Tarnovean/Analog-Signal-Conditioning-Interface/Docs/SCIA_Proiect.pdf

## Facultatea de Electronică, Telecomunicaţii şi Tehnologia Informaţiei

## PROIECT LA DISCIPLINA SCIA

## SEMESTRUL I

2026

## Student:Tarnovean Andrei Gabriel

## Anul de studiu III EA

2 | P a g e

## Cuprins

1. Tematica proiectului
1.1. AI standard cu 3 AO
1.2. Low pass 3 AO V-V KHN
1.3. RG parallel neinversor
1.4. Redresoare bialternanta
2. Dimensionarea etajelor
2.1. AI standard cu 3 AO
2.2. Low pass 3 AO V-V KHN
2.3. RG parallel neinversor
2.4. Redresoare bialternanta
3. Caracterizarea etajelor
3.1. LTspice

3.1.1 AI standard cu 3 AO

3.1.2 Low pass 3 AO V-V KHN

3.1.3 RG parallel neinversor

3.1.4 Redresoare bialternanta

3.2. Scopy

3.2.1 AI standard cu 3 AO

3.2.2 Low pass 3 AO V-V KHN

3.2.3 RG parallel neinversor

3.2.4 Redresoare bialternanta

4. Verificarea si caracterizarea interfetei analogice
5. Concluzii
5.1. AI standard cu 3 AO
5.2. Low pass 3 AO V-V KHN
5.3. RG parallel neinversor
5.4. Redresoare bialternanta

## 1. Tematica proiectului

Structura proiectului este formata din patru etaje : 1) AI standard cu 3 AO, 2) filtrul Low pass 3 AO V-V KHN , 3) configurația RG parallel , 4) Redresorul bialternanță, urmand sa fie dimensionate , simulate si implementate

### 1.1. AI standard cu 3 AO

Acest circuit este un amplificator de instrumentație de tip Tensiune-Tensiune

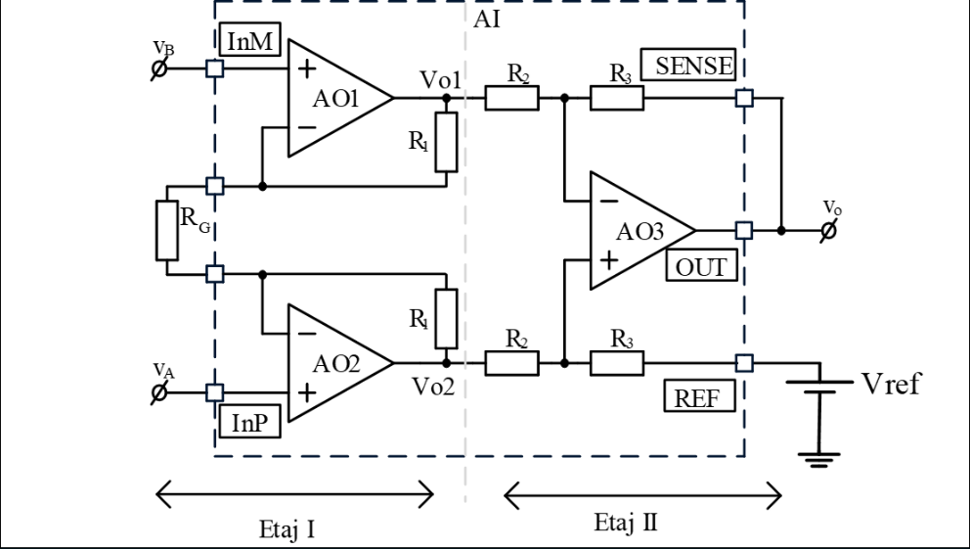
[picture p1: figure]

Acest amplificator de instrumentație cu 3 AO este conceput pentru extragerea precisă a semnalelor mici din medii zgomotoase. Primul etaj captează semnalul fidel, fără a-l influența , iar al doilea elimină interferențele, oferind un semnal de ieșire clar și curat.

### 1.2. Low pass 3 AO V-V KHN

Circuitul reprezintă un filtru biquad universal KHN (Kerwin-Huelsman-Newcomb) în mod tensiune-tensiune cu 3 amplificatoare operaționale, oferind simultan ieșiri low-pass band-pass și high-pass.

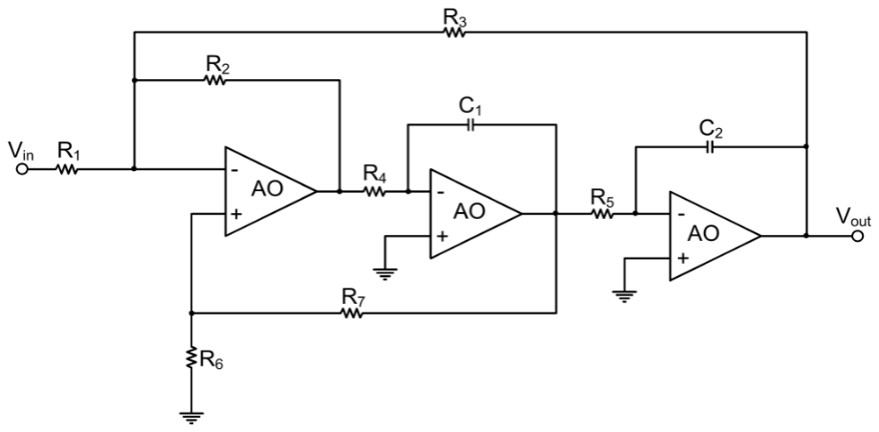
[picture p2: figure]

Funcționează pe bază de două integrate în buclă cu un sumarizator. Ieșirea low-pass are funcția de transfer standard de ordin 2

### 1.3. RG parallel neinversor

Circuitul PGA RG paralel neinversor reprezintă un amplificator operațional (AO) în configurație neinversoare, cu câștig programabil prin comutarea paralelă a rezistențelor la intrarea inversoare (RG echivalent variabil), Rf fixă la ieșire

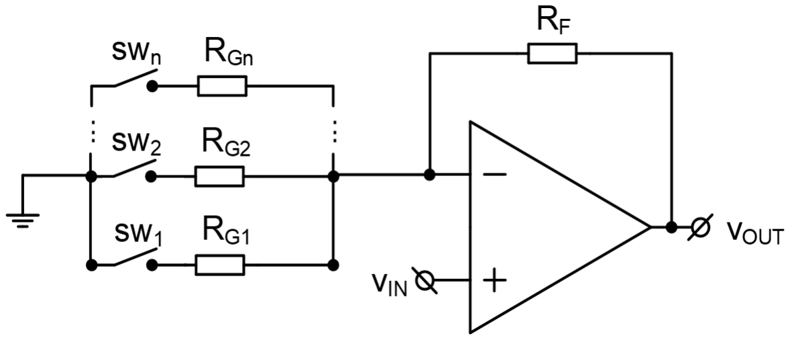
[picture p3: figure]

## 1.4. Redresoare bialternanta

Circuitul reprezintă un redresor de precizie bialternanță realizat cu două amplificatoare operaționale și două diode, unde primul AO funcționează în configurație inversoare pentru redresarea alternanței negative, iar al doilea în configurație neinversoare pentru combinarea semnalelor, rezultând ieșirea ∣ Vout ∣= Av ∣ Vin ∣ pe întreg ciclul

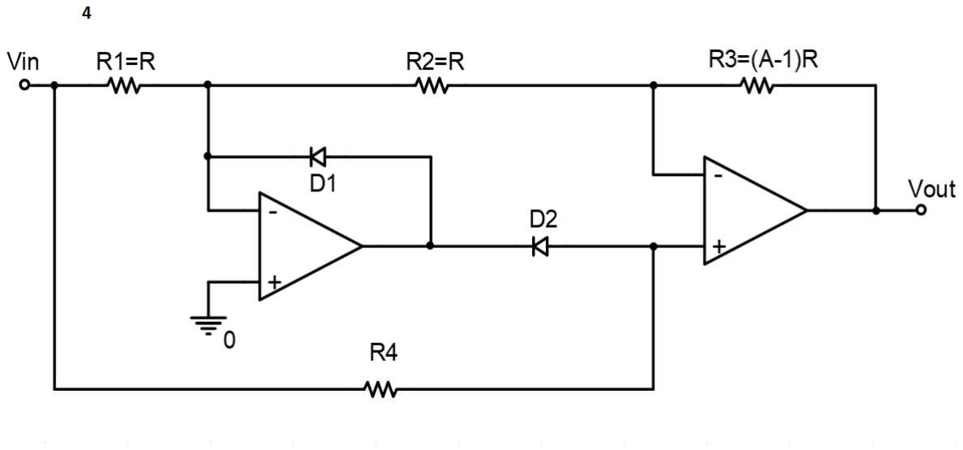
[picture p4: figure]

## 2. Dimensionarea etajelor

### 2.1. AI standard cu 3 AO

Dimensionarea acestui etaj a fost realizată astfel încât să respecte următoarele specificații de proiectare:

1. Amplitudinea minimă la intrare (pentru câștigul maxim PGA): 0.1163 V.
2. Amplitudinea maximă la intrare (pentru câștigul minim PGA): 0.2322 V.
3. Câștigul diferențial Ad = 3.

Considerăm R1 = R2 = R3 = 10k Ω

Ecuatia amplificari diferentiale:

Ad = (1 +

2R1
RG

)

R3
R2

3 = (1 +

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
RG = 10k

### 2.2. Low pass 3 AO V-V KHN

Dimensionarea acestui etaj a fost realizată astfel încât să respecte următoarele specificații de proiectare:

1. |H0| castig liniar in banda de trecere = 1
2. R intrare minim = 750Ω
3. Banda = 7000 Hz
4. Q = 1

Considerăm R1=R2=...=R7=R , rezulta H0 = 1

ω0 = 2π ∗ 7k

Q =

2
3

√
C1
C2

= 1 => C1 =

9
4

C2

Presupunem ca R = 750 Ω , C1 =

3Q
2ω0R

=> C1 = 47nF

Rezultate finale C1 = 10 nF , C2 = 4.7 nF , Q = 0.988 ≅ 1 , R = 4.7k Ω

### 2.3. RG parallel neinversor

Dimensionarea acestui etaj a fost realizată astfel încât să respecte următoarele specificații de proiectare:

1. castig minim [dB] = 8
2. rezolutie (pas minim) [dB] = 2
3. nr pasi = 4
4. castig maxim [dB] = 14

Stabilim RF = 10k

Castigul este : AV = 1 +

RF

RGn + RDSn

Considerând că RDS(on) << RGn , impactul asupra câștigului final fiind sub 0.2%.

RGn =

RF
AV − 1
i. AV,1 = 8 dB => AV,1 = 2.51 V , RG1 =

10k
2.51−1

, RG1 ≈ 6.8 K Ω

ii. AV,2 = 10 dB => AV,2 = 3.16 V , RG2 =

10k
3.16−1

, RG2 ≈ 4.7 K Ω

iii. AV,3 = 12 dB => AV,3 = 3.98 V , RG3 =

10k
3.98−1

, RG3 ≈ 3.3 K Ω

iiii. AV,4 = 14 dB => AV,4 = 5.01 V , RG4 =

10k
5.01−1

, RG4 ≈ 2.2 K Ω

BW =

GBW
AV

=

GBW
1+

RF
RGn

, pentru AD820 GBW = 1.9Mhz

SW4 | SW3 | SW2 | SW1 | RGn | Av | Av [dB] | Eroare [dB] | BW
1 | 0 | 0 | 0 | 2.2 kΩ | 5.55 | 14.9 | +0.9 | 324 k
0 | 1 | 0 | 0 | 3.3 kΩ | 4.03 | 12.1 | +0.1 | 447 k
0 | 0 | 1 | 0 | 4.7 kΩ | 3.13 | 9.9 | -0.1 | 575 k
0 | 0 | 0 | 1 | 6.8 kΩ | 2.47 | 7.9 | -0.1 | 729 k

## 2.4. Redresoare bialternanta

Dimensionarea acestui etaj a fost realizată astfel încât să respecte următoarele specificații de proiectare:

1. |Castig| (linear) = 2

Vout =
{

(1 +

R3
R2

) Vin, Vin < 0

− (

R2 + R3
R1

)Vin, Vin > 0

Conditia de Redresor Bialternanta: (R2+R3)
R1

= 1 +

R3
R2

⇒ R1 = R2

Vout = A ∗ Vin ⇒ A = 1 +

R3
R2

= 2 ⇒

R3
R2

= 1 ⇒ R3 = R2

Stabilim : R1 = R2 = R3 = R4 = 10k

## 3. Caracterizarea etajelor

3.1.LTspice

Implementarea circuitelor în LTspice s-a realizat utilizând modelul amplificatorului operațional AD820, conform cerințelor impuse în specificațiile de proiectare.

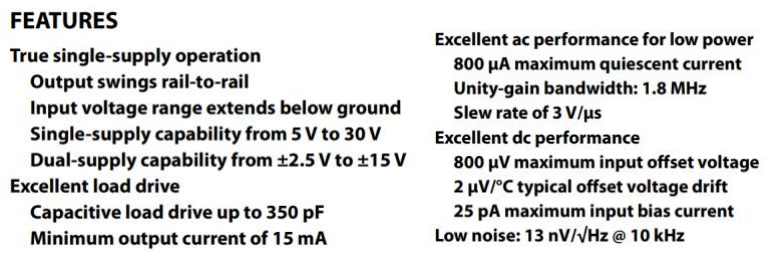
[picture p5: figure]

### 3.1.1. AI standard cu 3 AO

Figura de mai jos ilustrează implementarea completă a circuitului în mediul de simulare LTspice :

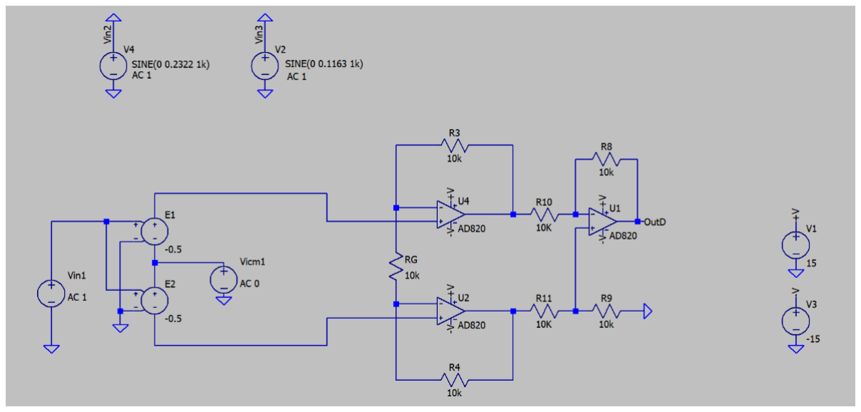
[picture p6: figure]

Pentru generarea semnalului s-a utilizat un model de sursă diferențială echilibrată, configurată pentru a genera cele două niveluri de test necesare analizei PGA: tensiunea minimă de 0.1163 V și tensiunea maximă de 0.2322 V.

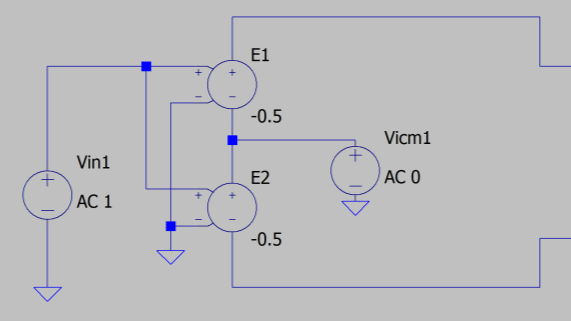
[picture p7: figure]

Pentru validarea funcționalității și caracterizarea performanțelor circuitului proiectat, au fost efectuate următoarele tipuri de analize în mediul de simulare LTspice.

DC op pnt:

Analiza punctului static de funcționare (DC) s-a realizat pentru ambele cazuri, rezultatele simulării fiind prezentate mai jos:

- punct static de functionare correct
Vid = 0.1163 V | Vid = 0.2322V

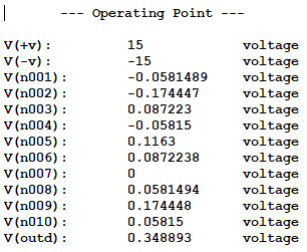
[picture p8: figure]
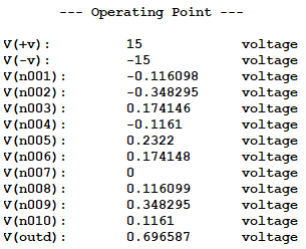
[picture p9: figure]

Valorile simulate (0.34889 V / 0.69658 V) coincid cu cele teoretice, demonstrând un câștig exact de 3 și o polarizare corectă a amplificatoarelor AD820, departe de limitele de saturație

-compensare/ajustare nivel DC la iesire

Pentru a demonstra ajustare a nivelului DC am introdus o tensiune de referință Vref= 1V

Vid = 0.1163 V

Vid = 0.2322 V

AC :

Analiza răspunsului în frecvență a circuitului s-a efectuat utilizând directiva de simulare .ac dec 100 .01 10Meg

- castig la joasa frecventa

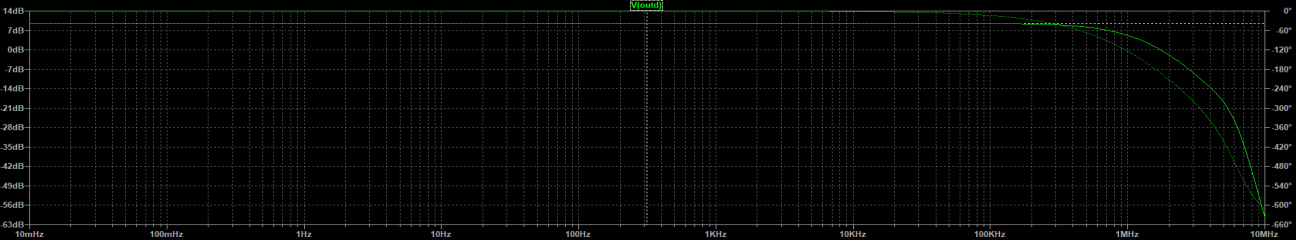
[picture p10: figure]
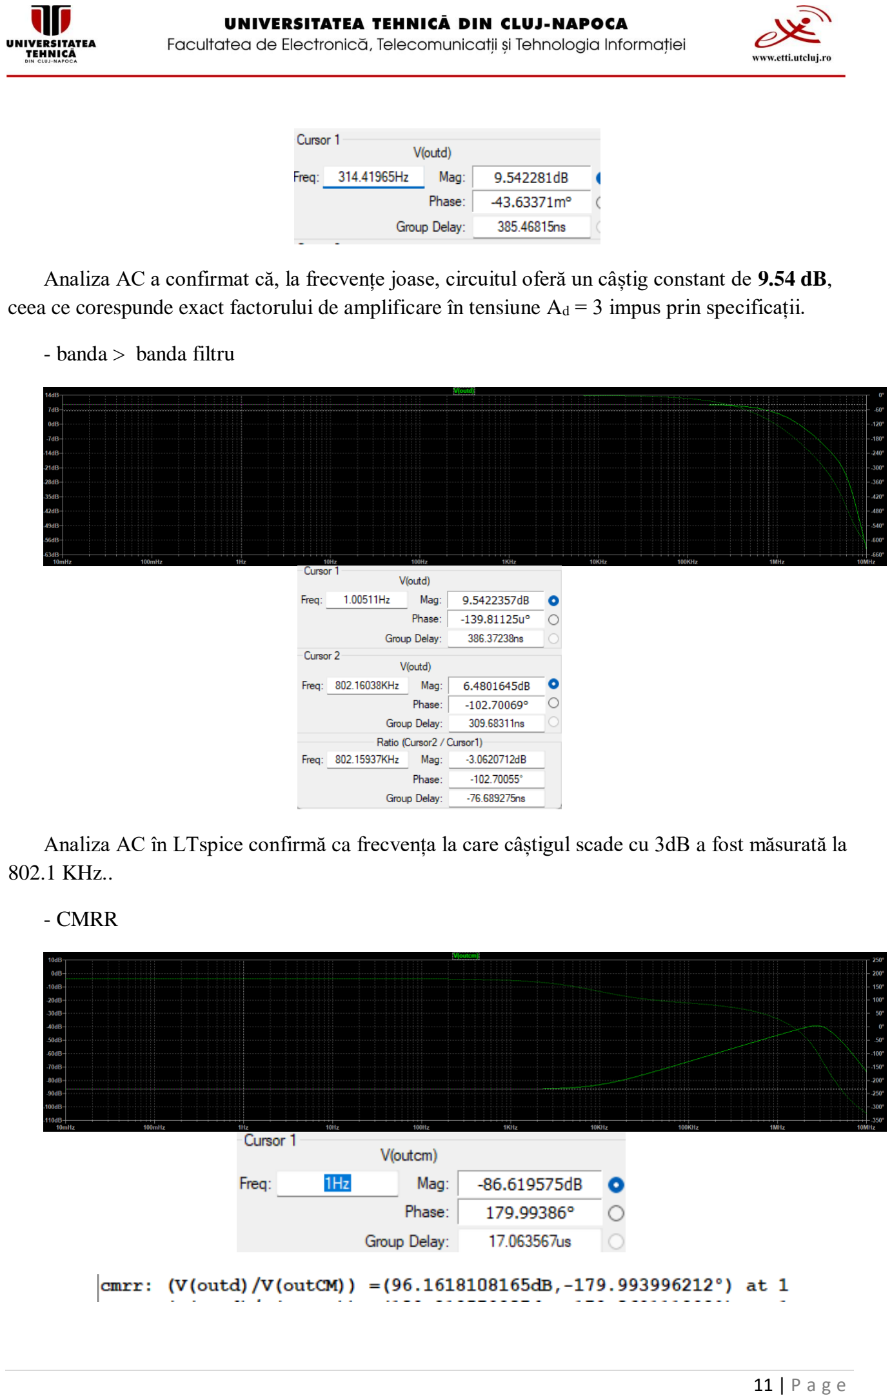
[picture p11: page 11]

Analiza AC a confirmat că, la frecvențe joase, circuitul oferă un câștig constant de 9.54 dB, ceea ce corespunde exact factorului de amplificare în tensiune Ad = 3 impus prin specificații.

- banda > banda filtru

Analiza AC în LTspice confirmă ca frecvența la care câștigul scade cu 3dB a fost măsurată la 802.1 KHz..

- CMRR

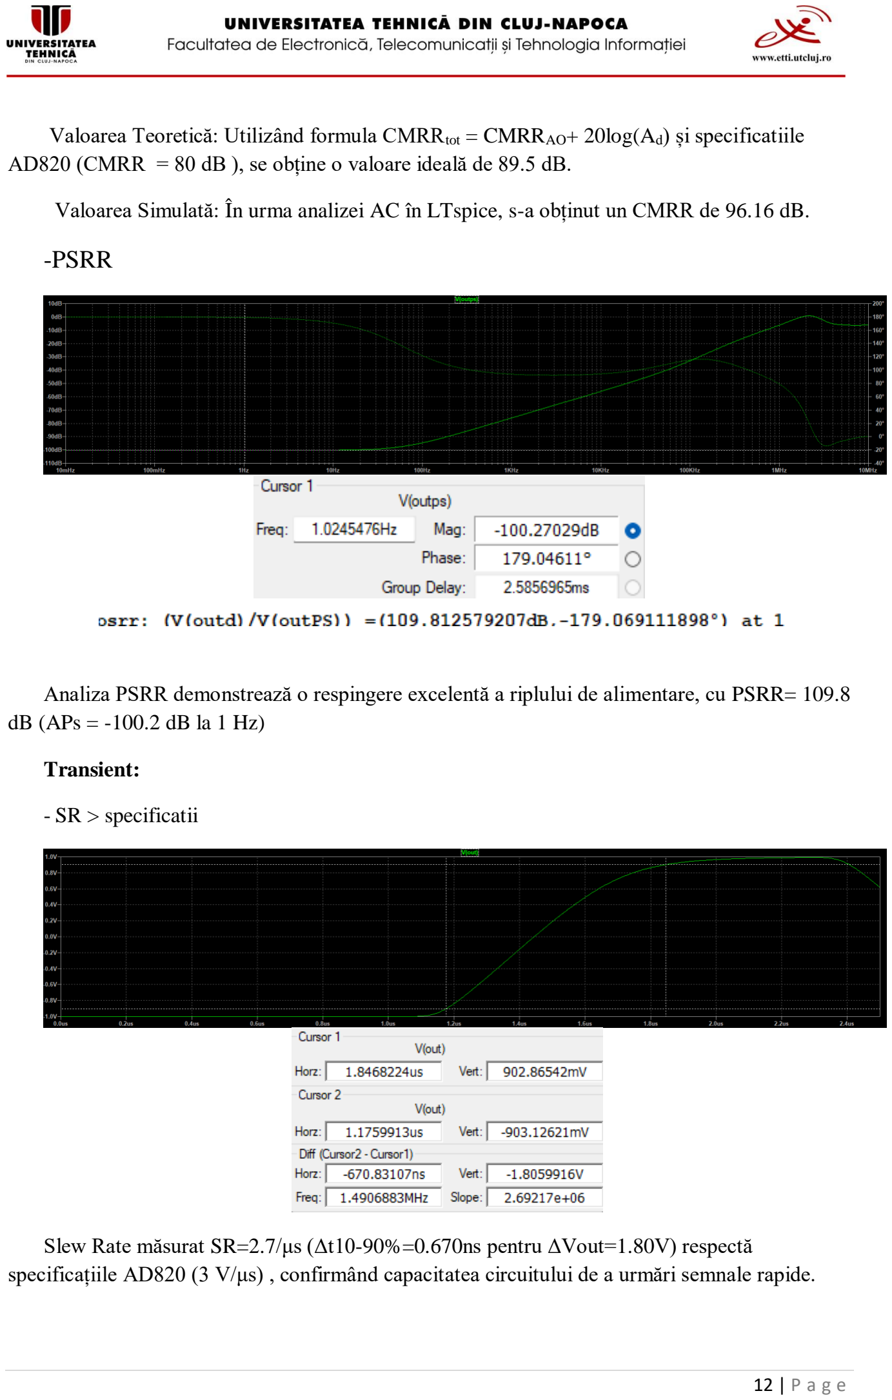
[picture p12: page 12]

Valoarea Teoretică: Utilizând formula CMRRtot = CMRRAO+ 20log(Ad) și specificatiile AD820 (CMRR = 80 dB ), se obține o valoare ideală de 89.5 dB.

Valoarea Simulată: În urma analizei AC în LTspice, s-a obținut un CMRR de 96.16 dB.

-PSRR

Analiza PSRR demonstrează o respingere excelentă a riplului de alimentare, cu PSRR= 109.8 dB (APs = -100.2 dB la 1 Hz)

Transient:

- SR > specificatii

Slew Rate măsurat SR=2.7/μs (Δt10-90%=0.670ns pentru ΔVout=1.80V) respectă specificațiile AD820 (3 V/μs) , confirmând capacitatea circuitului de a urmări semnale rapide.

- liniaritate > specs (pentru THD < 1%)

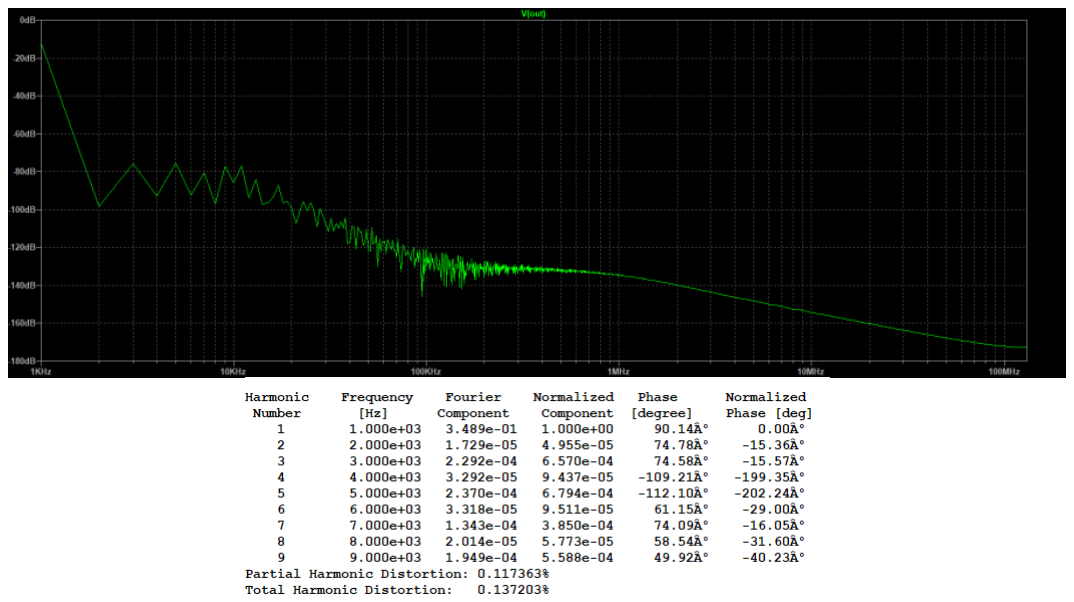
[picture p13: figure]

Analiza armonică prin FFT confirmă liniaritatea excelentă a AI, THD=0.137% <1%

### 3.1.2. Low pass 3 AO V-V KHN

Figura de mai jos ilustrează implementarea completă a circuitului Low pass 3 AO V-V KHN în mediul de simulare LTspice:

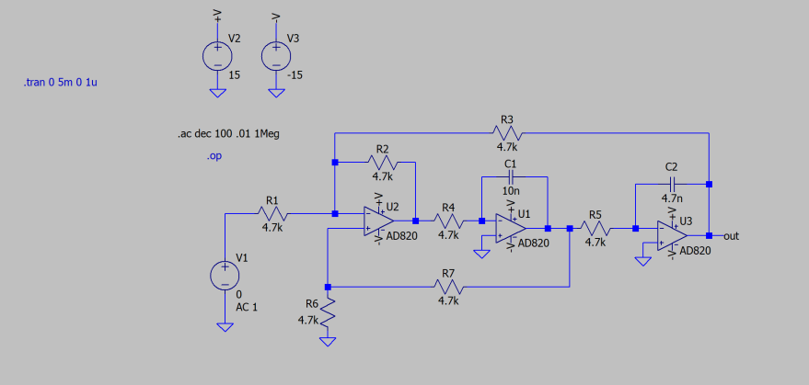
[picture p14: figure]

Pentru validarea funcționalității și caracterizarea performanțelor circuitului proiectat, au fost efectuate următoarele tipuri de analize în mediul de simulare LTspice.

DC op pnt:

- punct static de functionare correct

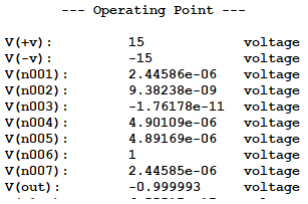
[picture p15: figure]

Analiza punctului static confirmă funcționarea corectă a circuitului KHN low-pass cu câștig H0 = 1. Sursa de intrare a fost setată la VIN = 1 V DC, rezultând VOUT ≈ 0.999 V (toate noduri ≈ 0-2.45 mV offset neglijabil). Alimentarea AO ±15 V este stabilă .

Analiza răspunsului în frecvență a circuitului s-a efectuat utilizând directiva de simulare .ac dec 100 .01 10k

-castig in banda de trecere = specs

- banda = specs

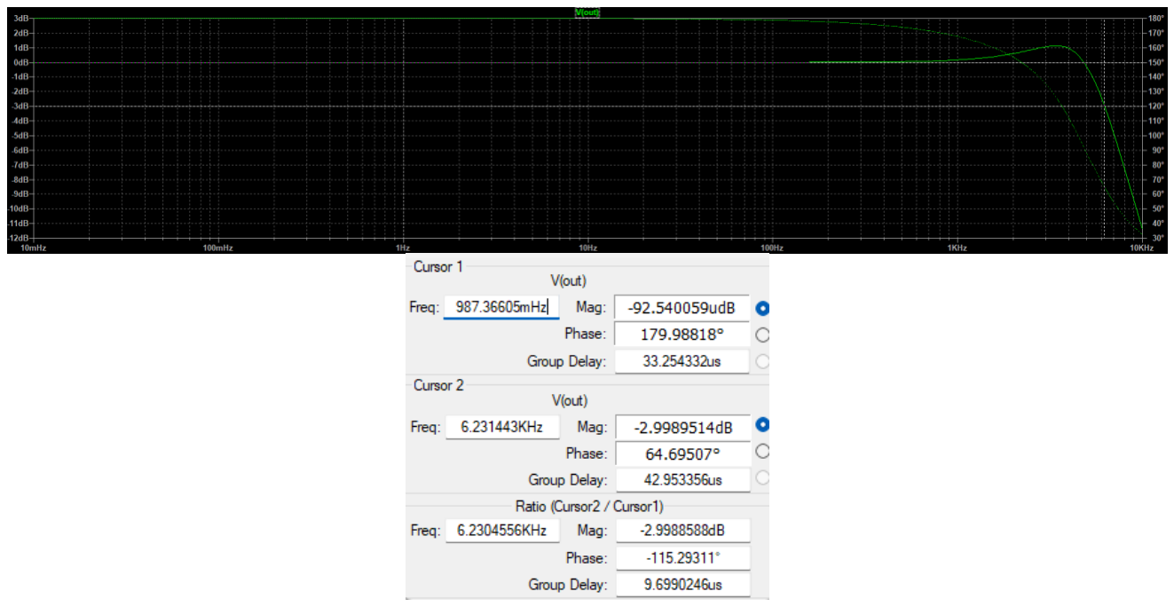
[picture p16: figure]

Concluzie simulări LTspice KHN :

Câștig banda de trecere: ≈0 dB până la 3 kHz → H0 = 1 respectat.

Frecvența de tăiere: fc = 6.23 kHz (specs 7 kHz, abatere -11% posibil din cauza toleranțelor ).

Q ≈ 1: Panta -40 dB/dec

Transient:

Pentru simularea de tip transient, s-a adaugat o sursa de tip SINE(0 1 1k) pe intrarea diferențială, simulare TRAN rulată cu .tran 0 5m 0 1u .
- liniaritate > specs

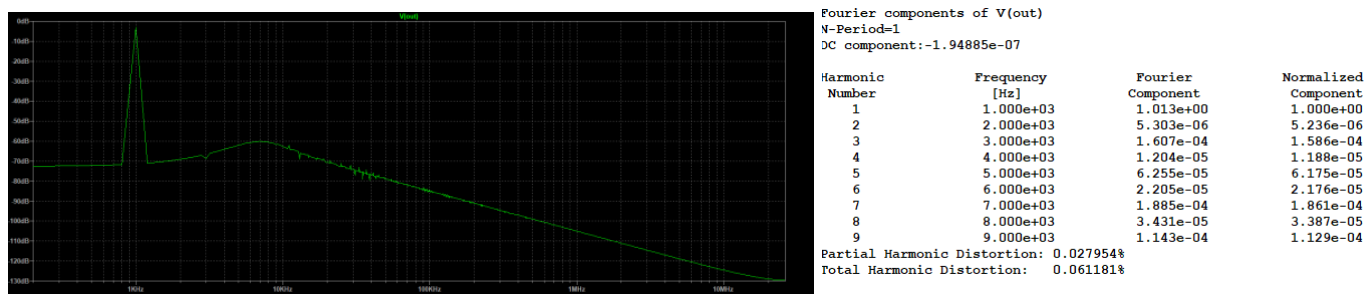
[picture p17: figure]

Analiza Fourier a semnalului de ieșire la frecvența de 1 kHz indică o Distorsiune Armonică Totală (THD) de numai 0,061%.

### 3.1.3. RG parallel neinversor

Figura de mai jos ilustrează implementarea completă a circuitului RG parallel neinversor în mediul de simulare LTspice:

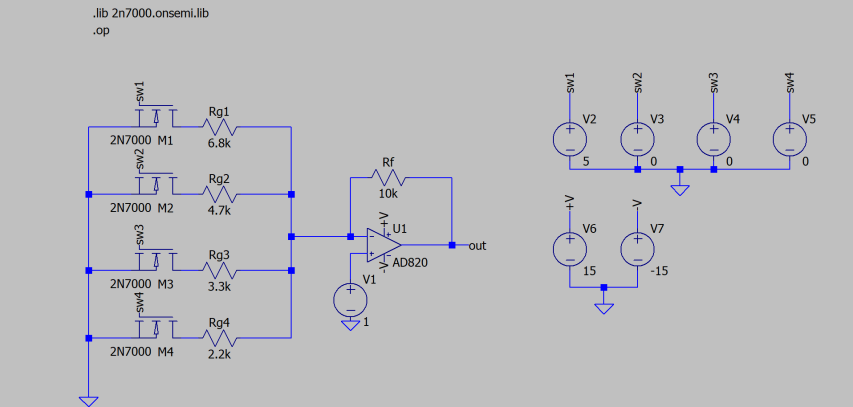
[picture p18: figure]

Pentru comutarea digitală a rezistențelor de setare a câștigului RGn, s-au utilizat tranzistoare MOSFET de semnal mic tip 2N7000.

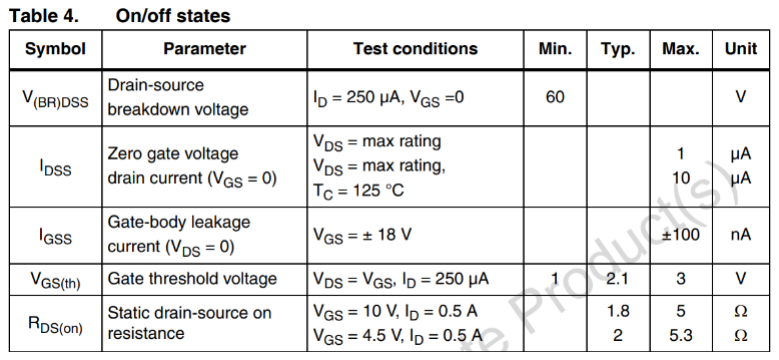
[picture p19: figure]

Pentru validarea funcționalității și caracterizarea performanțelor circuitului proiectat, au fost efectuate următoarele tipuri de analize în mediul de simulare LTspice.

DC op pnt:

- punct static de functionare correct

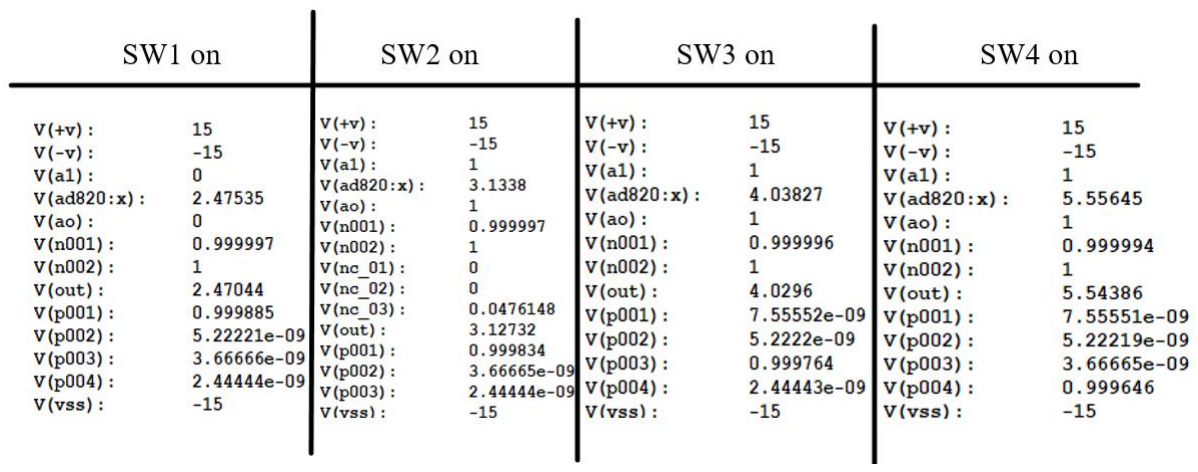
[picture p20: figure]
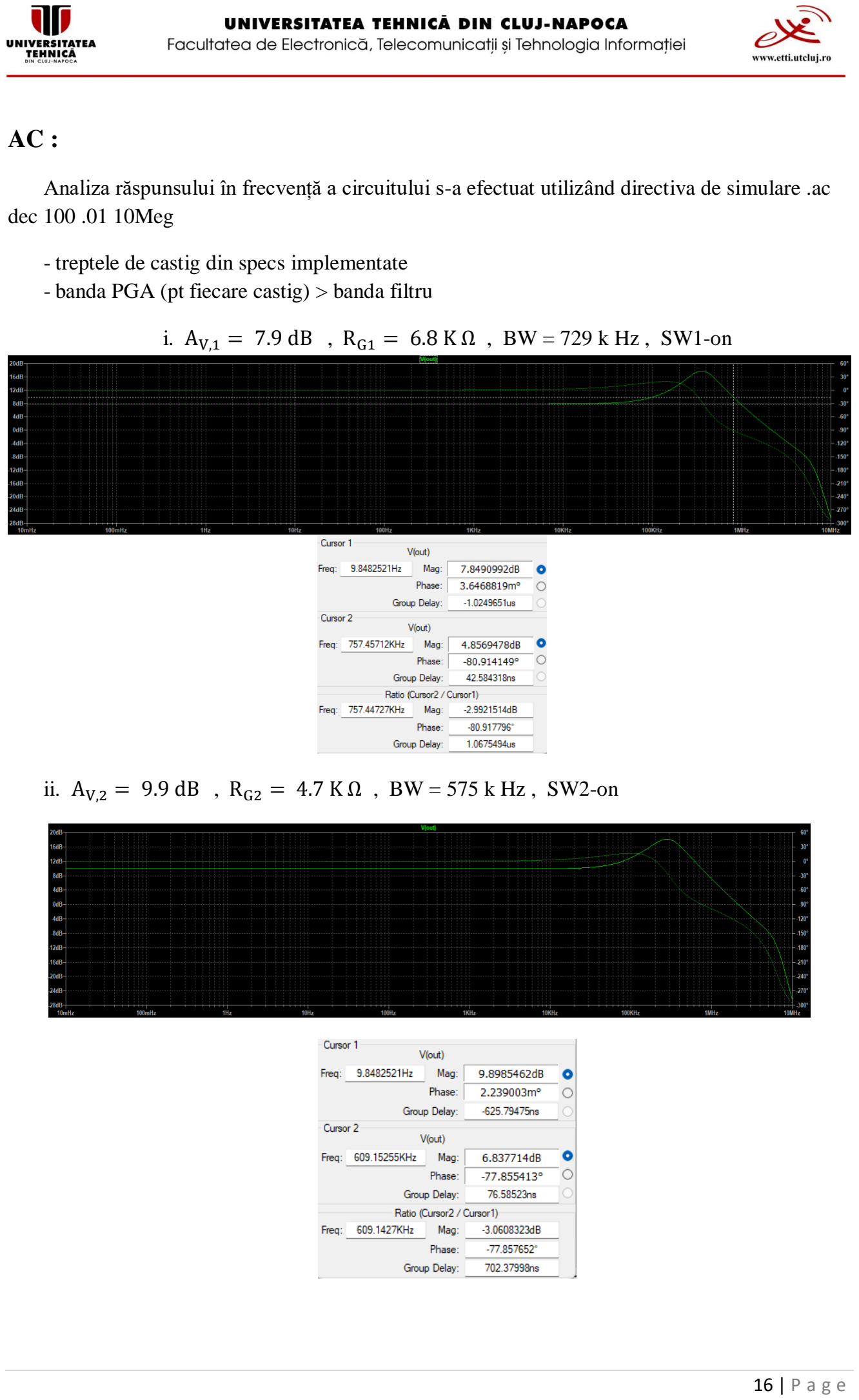
[picture p21: page 16]

AC :

Analiza răspunsului în frecvență a circuitului s-a efectuat utilizând directiva de simulare .ac dec 100 .01 10Meg

- treptele de castig din specs implementate
- banda PGA (pt fiecare castig) > banda filtru
i. AV,1 = 7.9 dB , RG1 = 6.8 K Ω , BW = 729 k Hz , SW1-on

ii. AV,2 = 9.9 dB , RG2 = 4.7 K Ω , BW = 575 k Hz , SW2-on

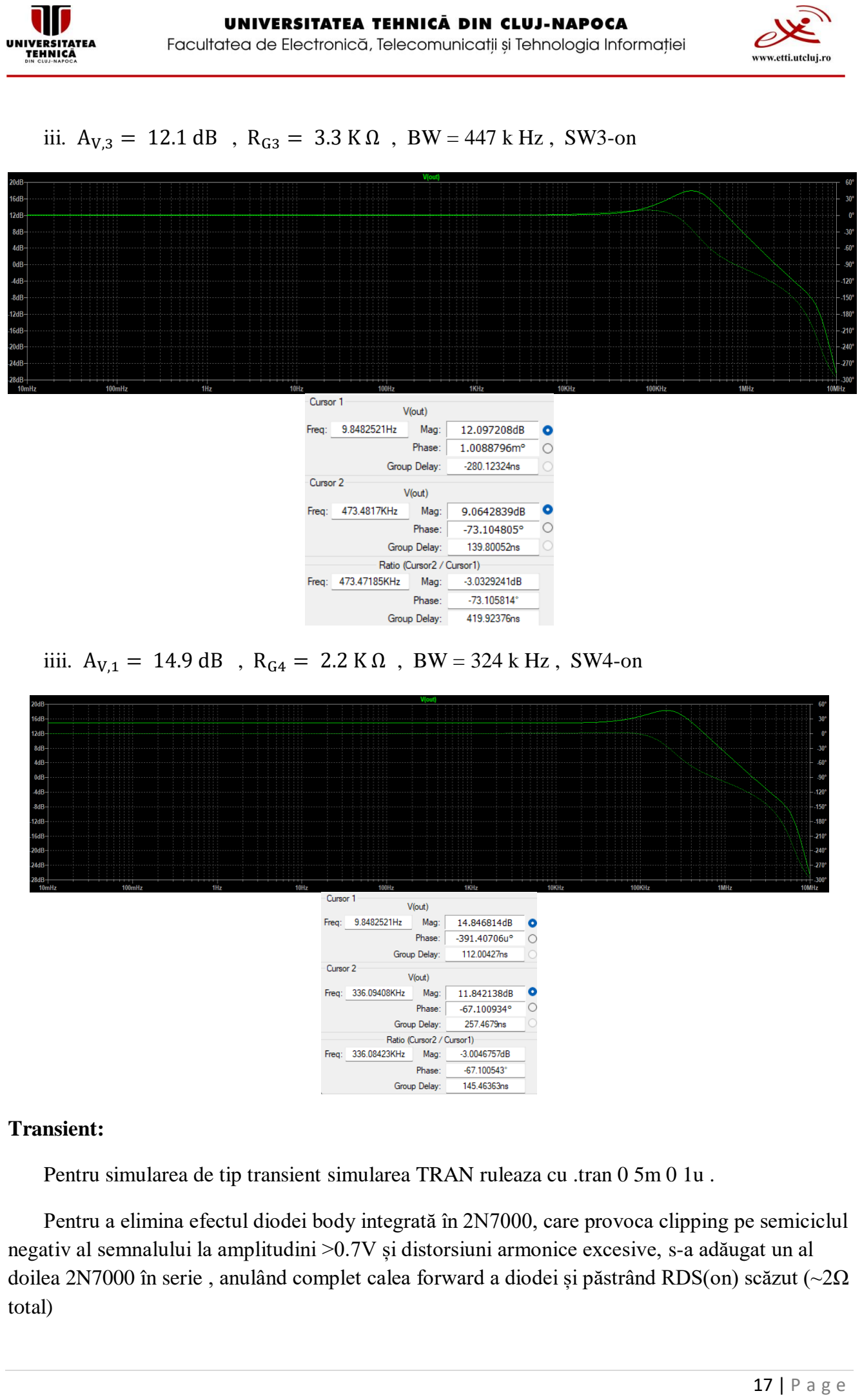
[picture p22: page 17]

iii. AV,3 = 12.1 dB , RG3 = 3.3 K Ω , BW = 447 k Hz , SW3-on

iiii. AV,1 = 14.9 dB , RG4 = 2.2 K Ω , BW = 324 k Hz , SW4-on

Transient:

Pentru simularea de tip transient simularea TRAN ruleaza cu .tran 0 5m 0 1u .

Pentru a elimina efectul diodei body integrată în 2N7000, care provoca clipping pe semiciclul negativ al semnalului la amplitudini >0.7V și distorsiuni armonice excesive, s-a adăugat un al doilea 2N7000 în serie , anulând complet calea forward a diodei și păstrând RDS(on) scăzut (~2Ω total)

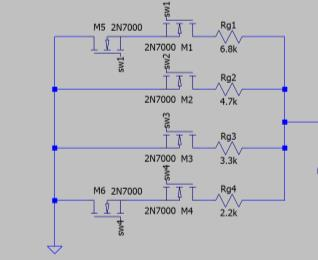
[picture p23: figure]

- liniaritate > specs pt castig min si input ampl max (pentru THD < 1%)

Vin_max =

VOUT_max
Av

=> Vin_max =

14.5
2.47 ≈ 5.8 V

S-a adaugat o sursa de tip SINE(0 5.8 1k) pe intrarea neinversoare a AO

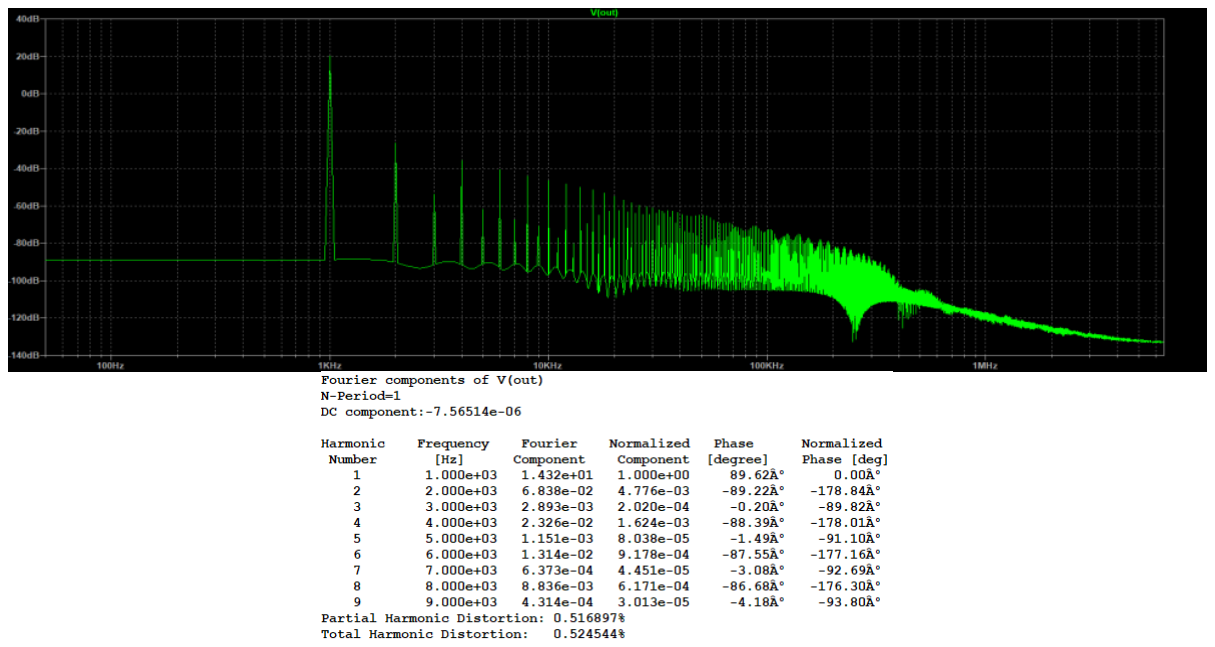
[picture p24: figure]

Liniaritatea PGA în configurația de câștig minim (SW1 activat) depășește specificațiile impuse, demonstrând un THD = 0.52% < 1% la Vin_max = 5.8 V.

- liniaritate > specs pt castig max si input ampl min (pentru THD < 1%)

S-a adaugat o sursa de tip SINE(0 0.02 1k) pe intrarea neinversoare a AO

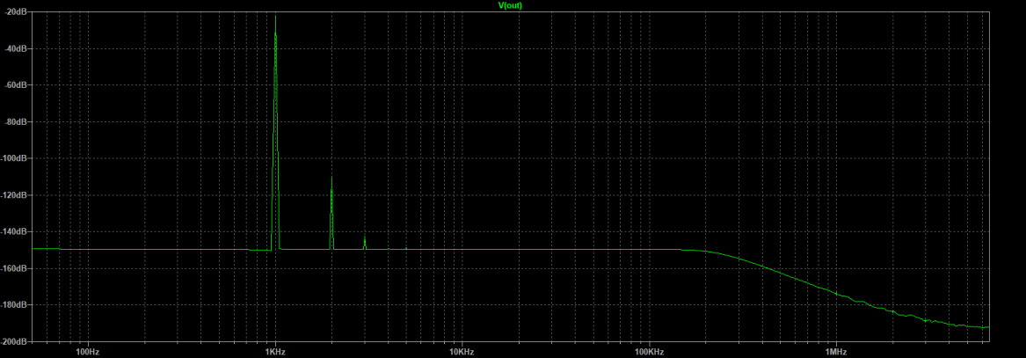
[picture p25: figure]
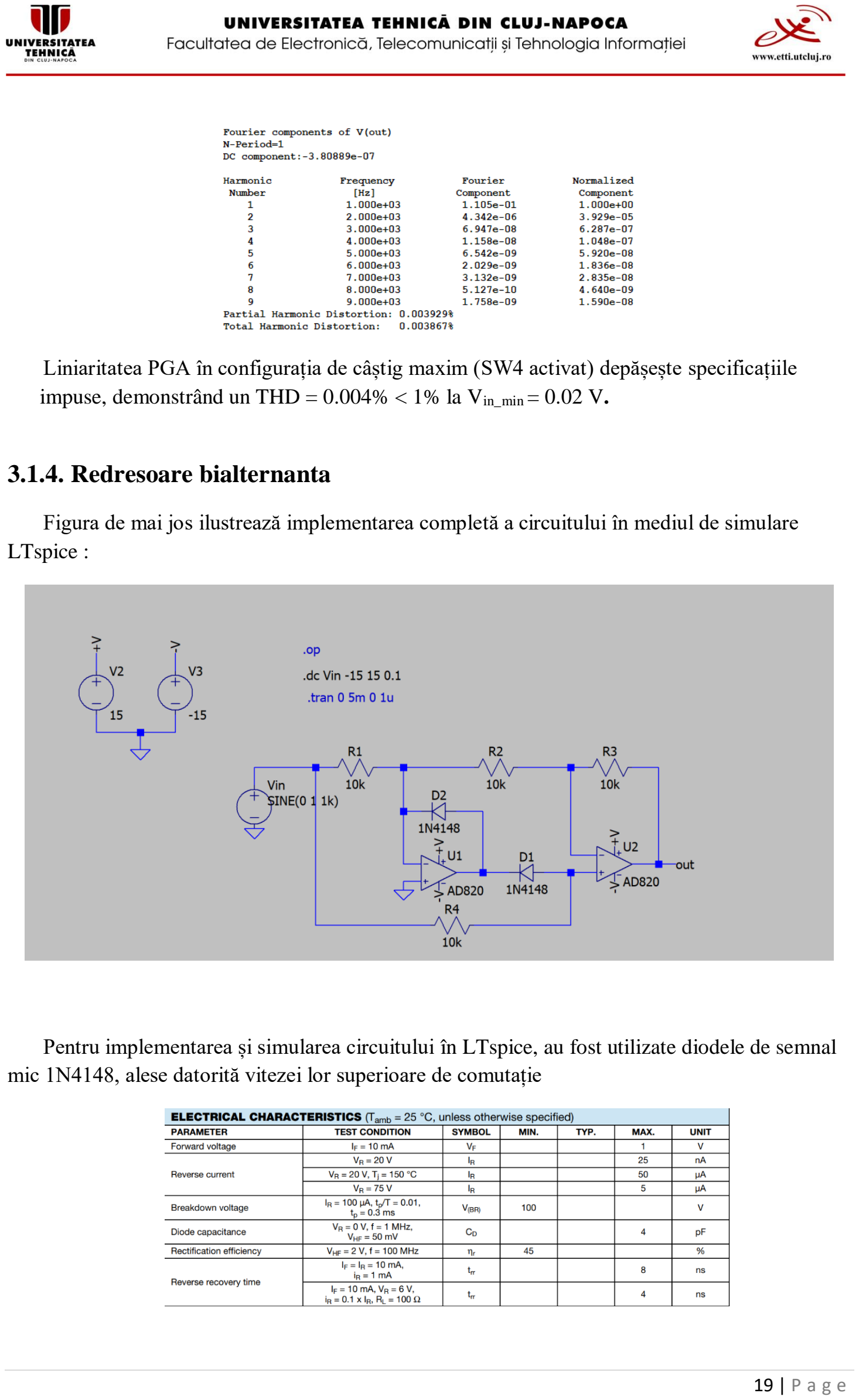
[picture p26: page 19]

Liniaritatea PGA în configurația de câștig maxim (SW4 activat) depășește specificațiile impuse, demonstrând un THD = 0.004% < 1% la Vin_min = 0.02 V.

### 3.1.4. Redresoare bialternanta

Figura de mai jos ilustrează implementarea completă a circuitului în mediul de simulare LTspice :

Pentru implementarea și simularea circuitului în LTspice, au fost utilizate diodele de semnal mic 1N4148, alese datorită vitezei lor superioare de comutație

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

DC op pnt:

- punct static de functionare correct

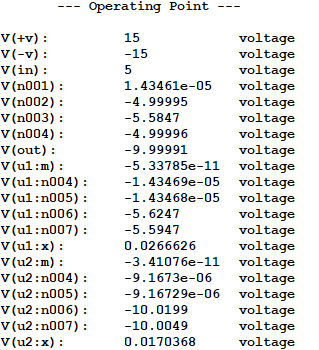
[picture p27: figure]

Analiza DC validează compensarea activă a pragului diodei (~0.58V) de către amplificatorul operațional, asigurând o tensiune de ieșire precisă de -10V pentru intrarea de 5V.

DC sweep + transient

Pentru acesta simulare de tip DC sweep + transient am folosit syntax .tran 0 5m 0 1u si .dc Vin -15 15 0.1

- castig = specs

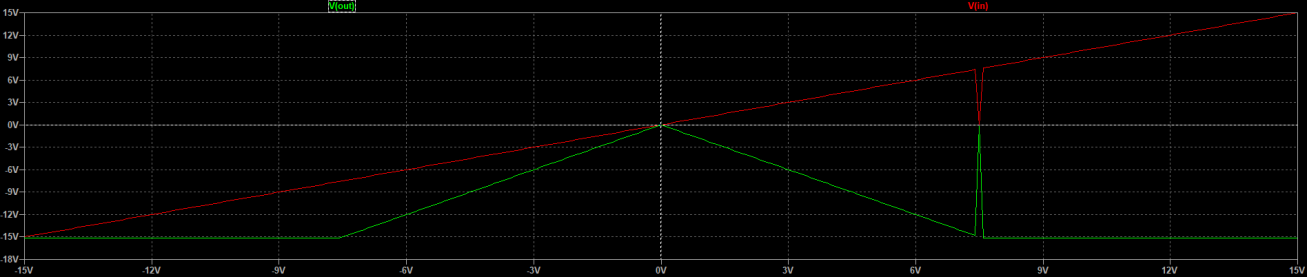
[picture p28: figure]

DC sweep

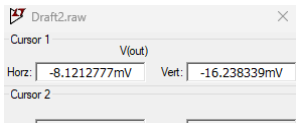
[picture p29: figure]

Caracteristica statică arată redresor bialternanță ideal cu panta Av = 2 (Vout = ±2 Vin), dead-zone neglijabilă

Pentru simularea de tip transient, s-a adaugat o sursa de tip SINE(0 5 1k)

Transient

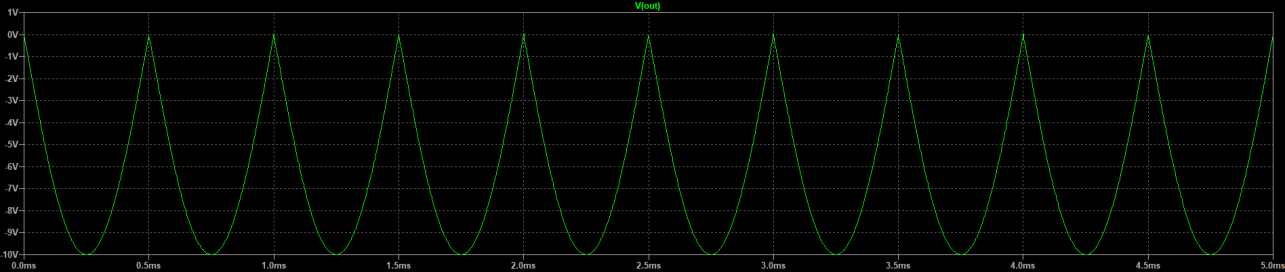
[picture p30: figure]

Redresare dinamică perfectă, Vout 10Vpp rectificat curat (THD minim, fără distorsiuni), confirmând funcționare la f=1kHz

Transient :

Pentru simularea de tip transient simularea TRAN ruleaza cu .tran 0 5m 0 1u .

- implementare functie de circuit

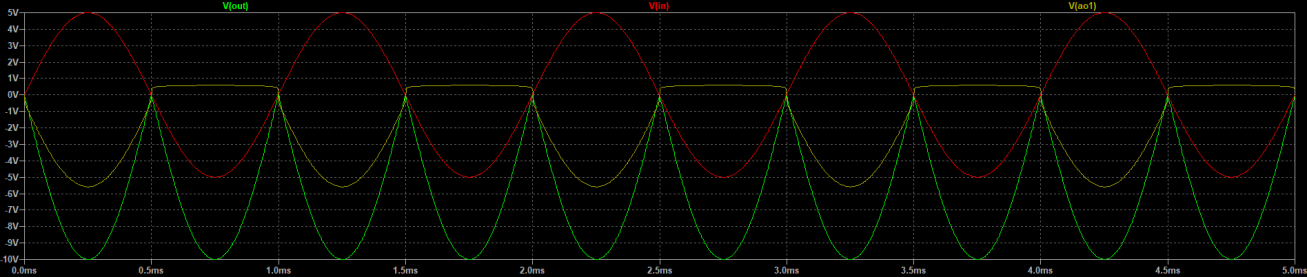
[picture p31: figure]

Redresarea: Ieșirea prezintă exclusive alternanțe negative, confirmând funcția de modul.

Precizia: Vârfurile de la trecerea prin zero sunt ascuțite, demonstrând absența distorsiunilor de prag.

Câștigul: Raportul dintre amplitudinea ieșirii 10V și cea a intrării 5V confirmă factorul de amplificare A = 2.

Trasul galben VAO1 , confirmă funcționarea primului etaj ca redresor monoalternanță, validând topologia circuitului.

- domeniu de functionare > amplitudine intrare maxima

Vin_max =

VOUT_max
Av

=> Vin_max =

14.9
2

≈ 7.45 V

Vin_max = SINE(0 8 1k)

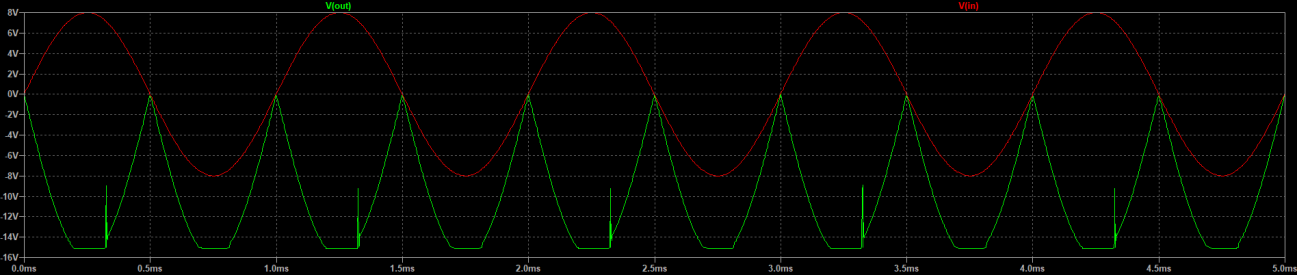
[picture p32: figure]

Graficul evidențiază fenomenul de limitare la nivelul tensiunii de alimentare. Tensiunea de ieșire se plafonează la aproximativ Vsat ≈ 14.9 V

Orice semnal de intrare care depășește 7.45V va introduce distorsiuni masive prin retezarea vârfurilor

3.2.Scopy

Pentru validarea experimentală a proiectului, implementarea fizică a fost testată și caracterizată cu ajutorul modulului ADALM2000, interfațat cu PC-ul prin mediul de lucru Scopy.

### 3.2.1. AI standard cu 3 AO

Amplificatorul de instrumentație standard cu trei amplificatoare operaționale a fost realizat utilizând circuitul integrat OP482.

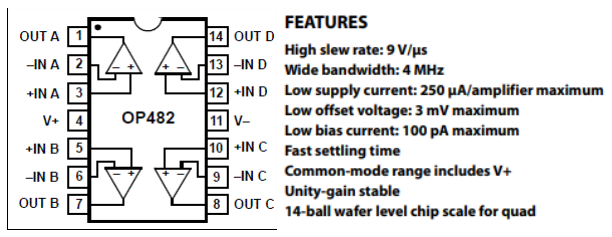
[picture p33: figure]

Pentru validarea funcționalității și caracterizarea performanțelor circuitului realizat fizic, au fost efectuate următoarele tipuri de măsurători :

- banda > banda filtru

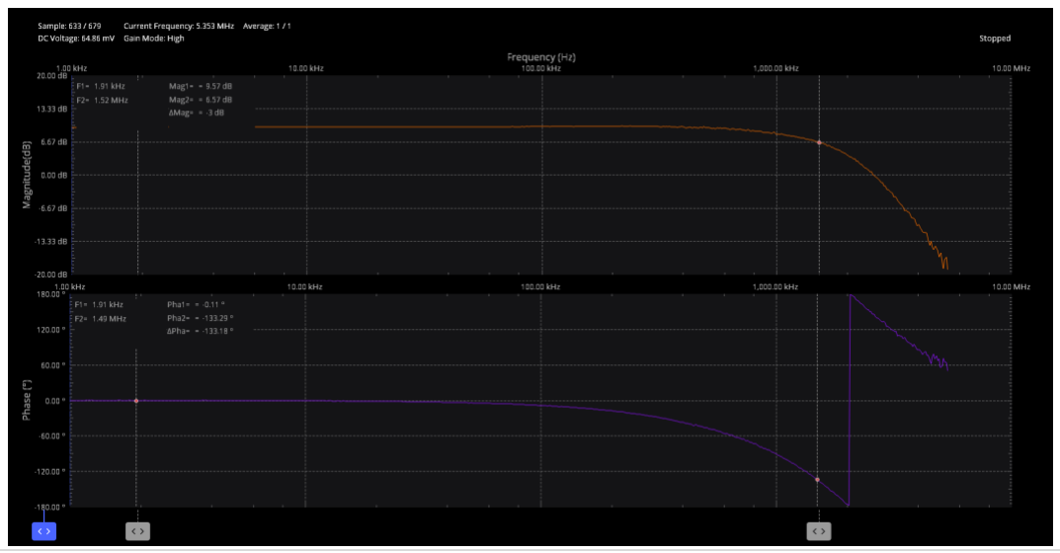
[picture p34: figure]

Măsurătoarea benzii pe Scopy cu OP482 indică f-3dB = 1.52 MHz (Ad = 9.57 dB), rezultând GBW = 4.56 MHz conform specificațiilor datasheet OP482 (GBW = 4 MHz). Banda depășește cu mult frecvența de tăiere a filtrului, validând implementarea.

-SR > specificati

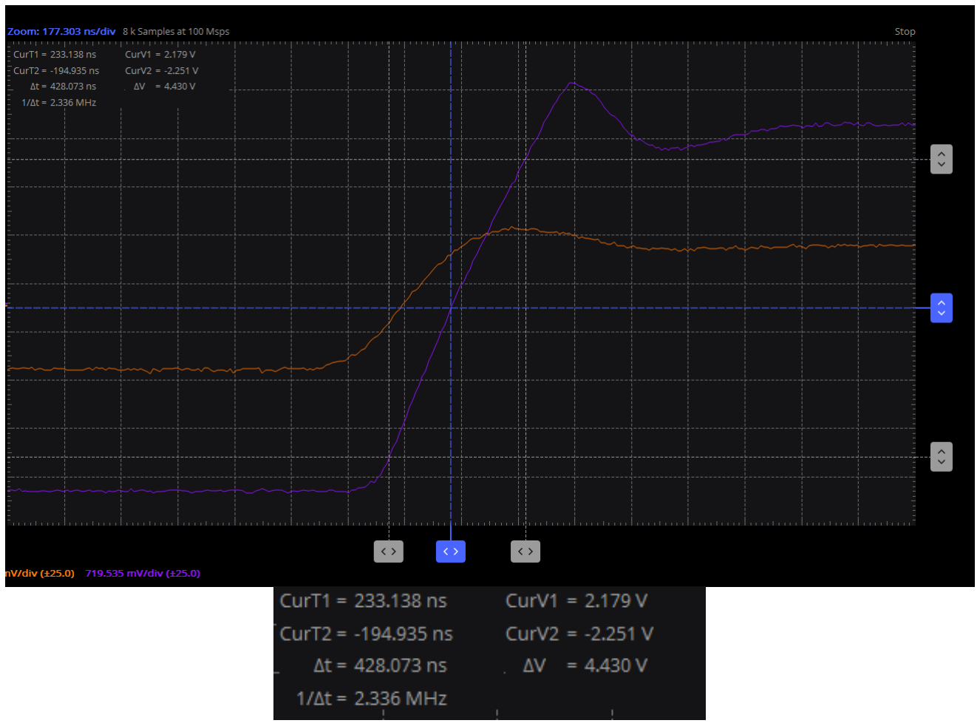
[picture p35: figure]

SR =

ΔV
Δt

=

4.430V
428.073ns ≈ 10.35

V
μs

Valoarea măsurată de 10.35 V/µs depășește specificația tipică de 9 V/µs din foaia de catalog, validând astfel performanța superioară a cipului OP482 și corectitudinea implementării fizice.

### 3.2.2. Low pass 3 AO V-V KHN

Implementarea filtrului Low-Pass KHN s-a bazat pe utilizarea a două integrate NE5532, asigurând astfel cele trei etaje necesare funcționării.

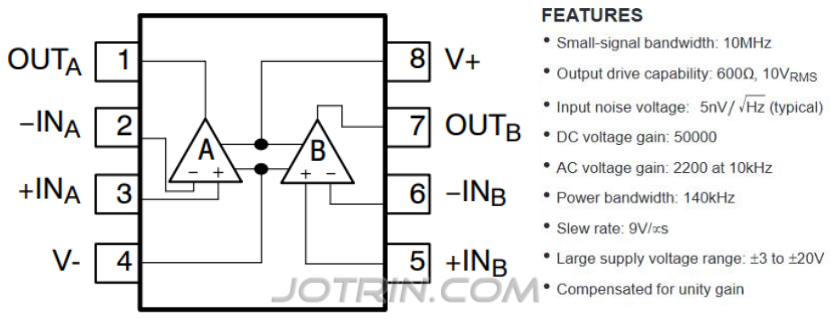
[picture p36: figure]

Pentru validarea funcționalității și caracterizarea performanțelor circuitului realizat fizic, au fost efectuate următoarele tipuri de măsurători :

-castig in banda de trecere = specs
-banda = specs

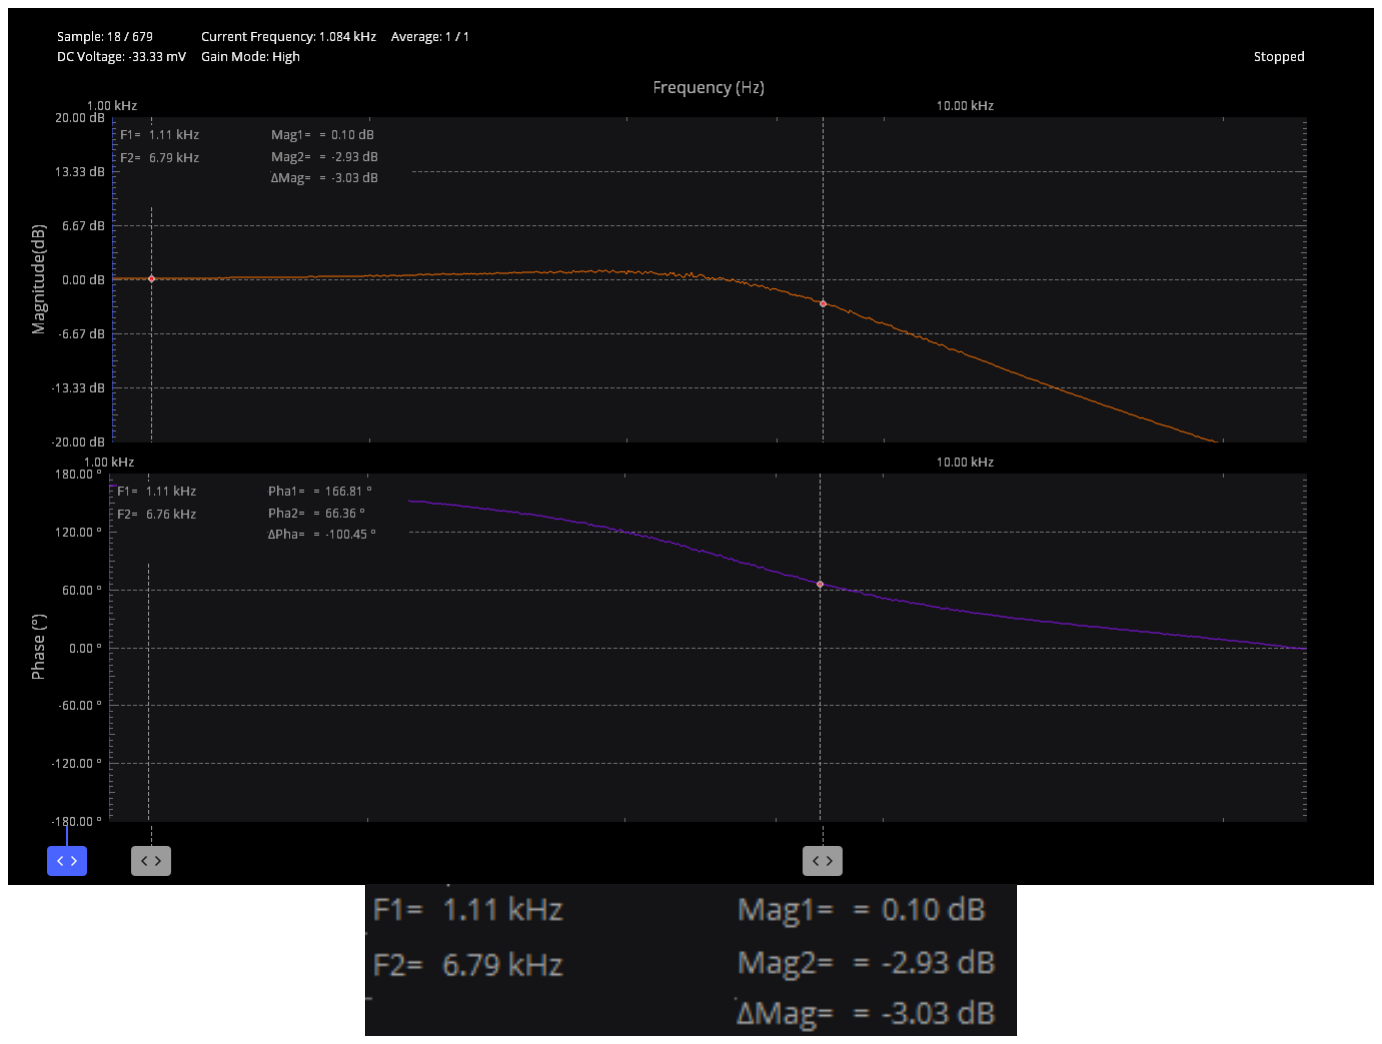
[picture p37: figure]

Circuitul KHN low-pass 3 AO implementat pe placă respectă specificațiile proiectului: -Câștig în bandă: H0 = -0.10 dB (≈ 0.99 linear) la 1.11 kHz .
-Banda de trecere: fc = 6.79 kHz (-2.93 dB) → ≈ specs (7 kHz), abatere -3%

Performanță: Panta -40 dB/dec confirmă Q ≈ 1, funcționare stabilă NE5532. Implementare validată experimental .

### 3.2.3. RG parallel neinversor

Pentru acest etaj, s-a optat pentru utilizarea circuitului integrat NE5532 în configurație neinversoare, controlul treptelor de amplificare fiind asigurat prin intermediul comutatorului analogic de precizie MAX4617

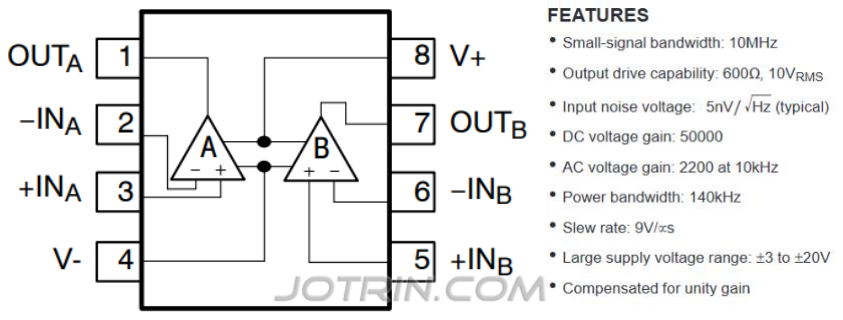
[picture p38: figure]
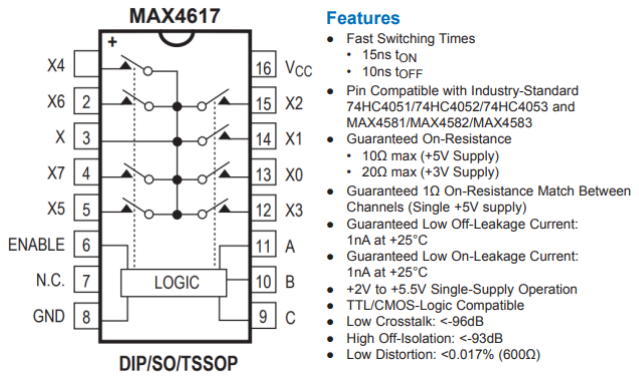
[picture p39: figure]

Pentru validarea funcționalității și caracterizarea performanțelor circuitului realizat fizic, au fost efectuate următoarele tipuri de măsurători :

- toate treptele de castig din specs implementate
- banda PGA (pt fiecare castig) > banda filtru
i. AV,1 = 7.9 dB , RG1 = 6.8 K Ω , BW = 729 k Hz , SW1-on

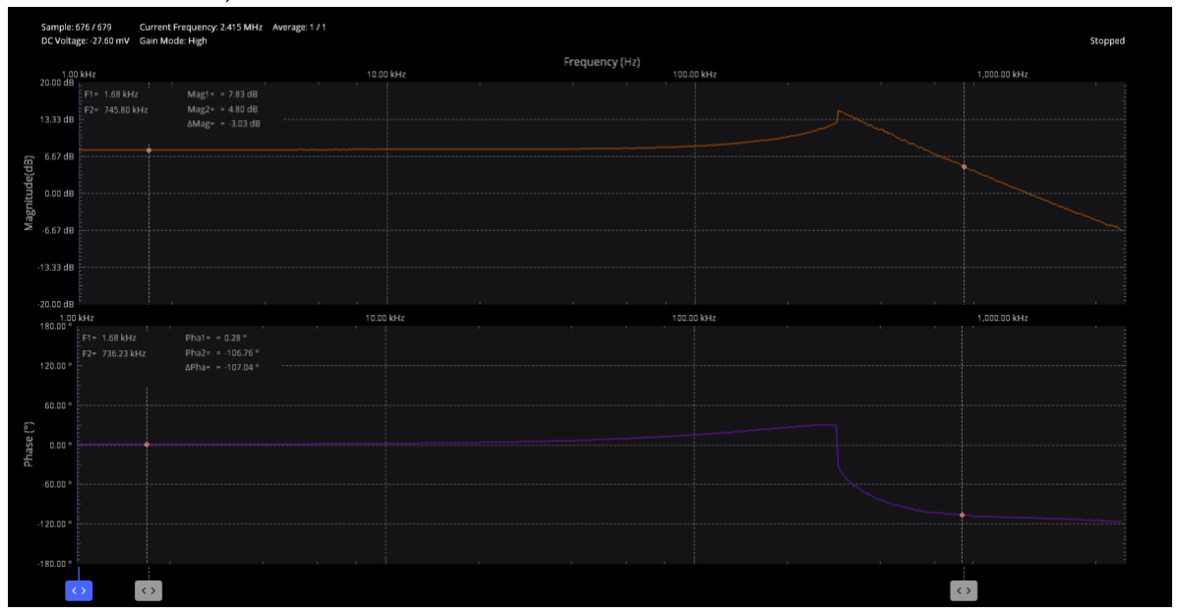
[picture p40: figure]
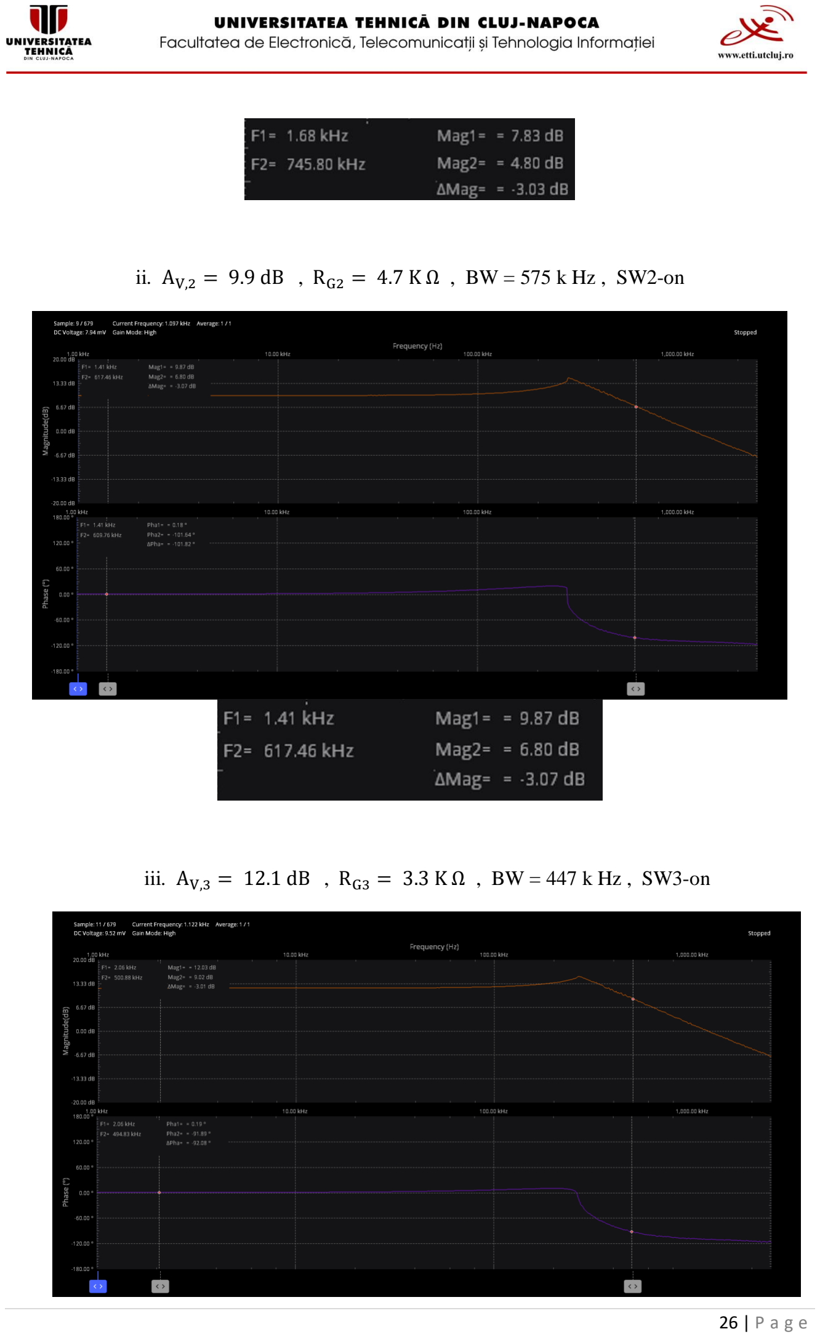
[picture p41: page 26]

ii. AV,2 = 9.9 dB , RG2 = 4.7 K Ω , BW = 575 k Hz , SW2-on

iii. AV,3 = 12.1 dB , RG3 = 3.3 K Ω , BW = 447 k Hz , SW3-on

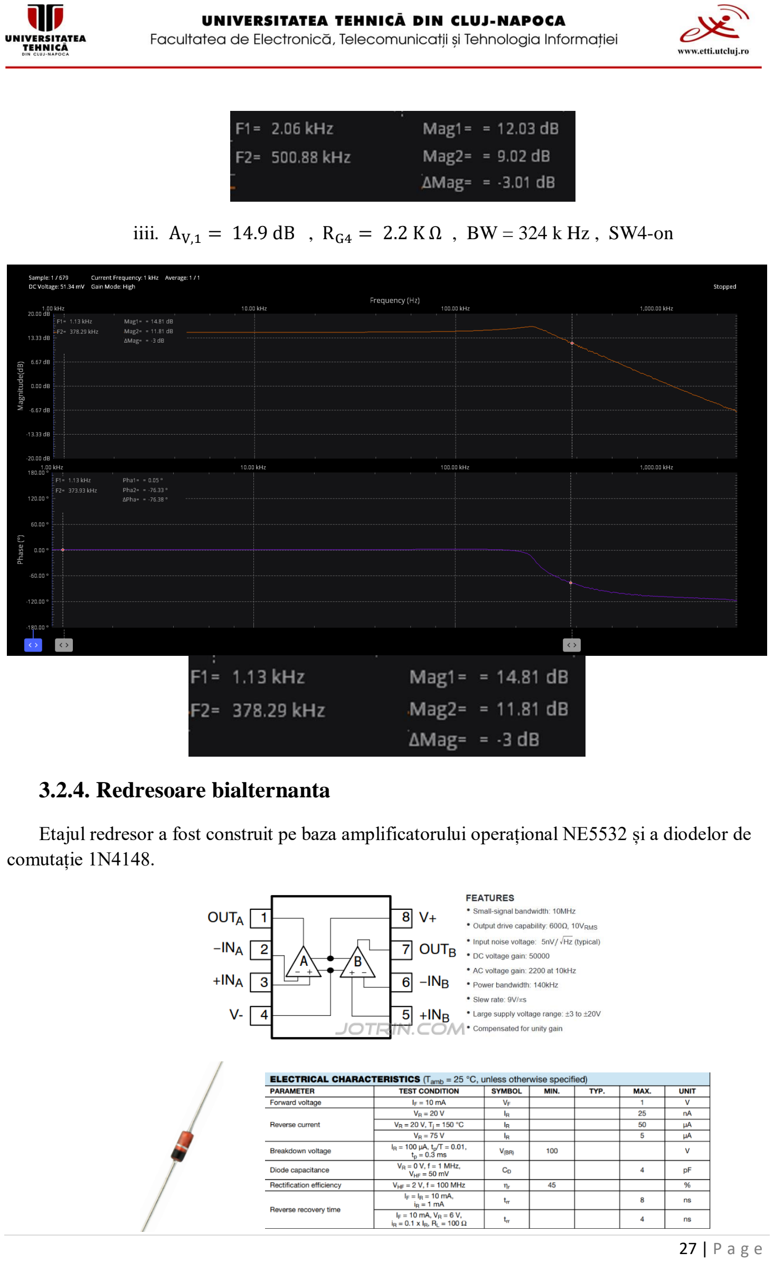
[picture p42: page 27]

iiii. AV,1 = 14.9 dB , RG4 = 2.2 K Ω , BW = 324 k Hz , SW4-on

### 3.2.4. Redresoare bialternanta

Etajul redresor a fost construit pe baza amplificatorului operațional NE5532 și a diodelor de comutație 1N4148.

Pentru validarea funcționalității și caracterizarea performanțelor circuitului realizat fizic, au fost efectuate următoarele tipuri de măsurători :

- implementare functie de circuit

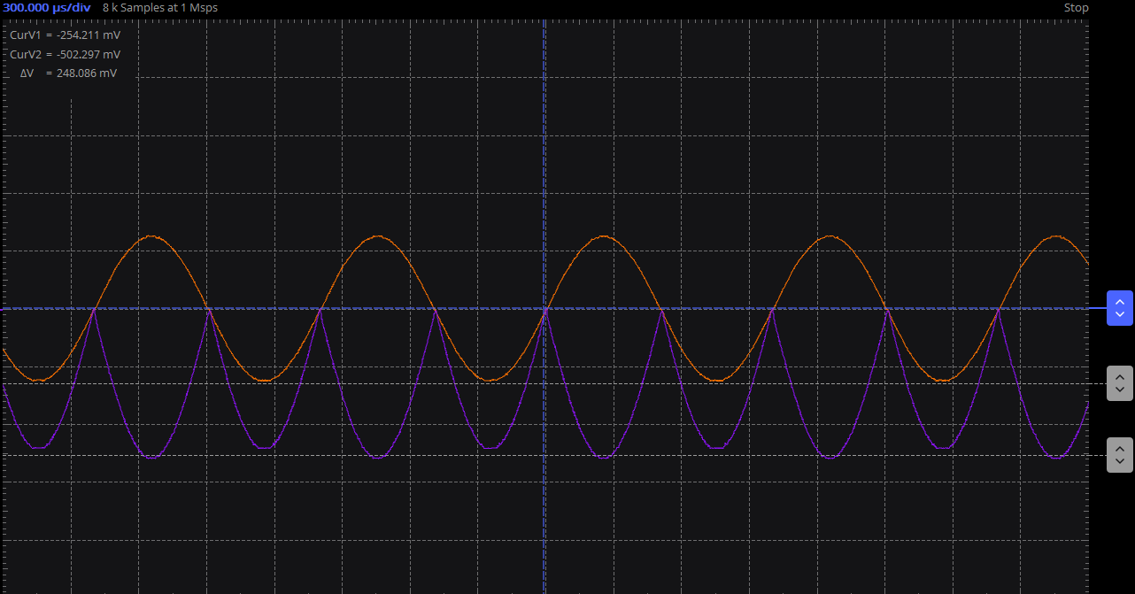
[picture p43: figure]

Simularea confirmă funcționarea circuitului ca redresor bialternanță pe alternanța negativă, realizând un câștig de tensiune de 2.

## 4. Verificarea si caracterizarea interfetei analogice

Pentru validarea funcționării globale a interfeței analogice și verificarea compatibilității între etaje, s-a realizat simularea completă a sistemului integrat utilizând LTspice.
Cele patru blocuri funcționale au fost convertite în simboluri LTspice, permițând o asamblare rapidă și ordonată a schemei finale a interfeței analogice.

Simbolurile schematice create pentru cele patru module componente:

- AI cu 3 AO

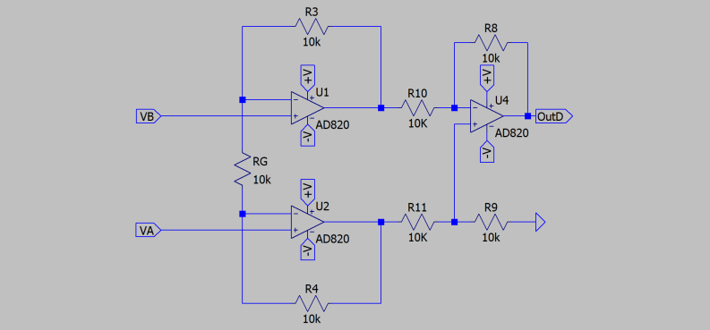
[picture p44: figure]

- Low pass 3 AO KHN
- PGA

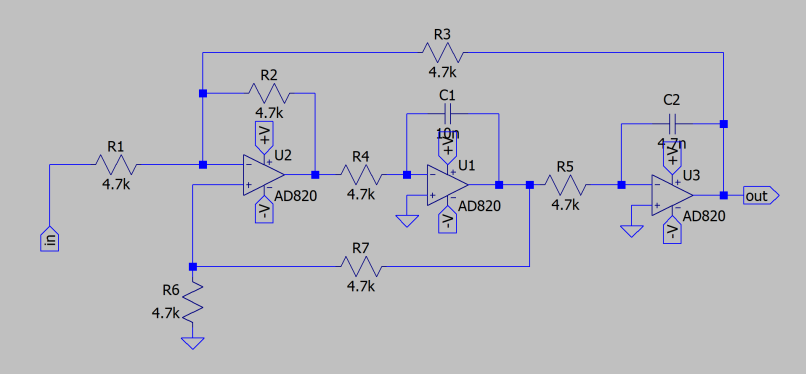
[picture p45: figure]
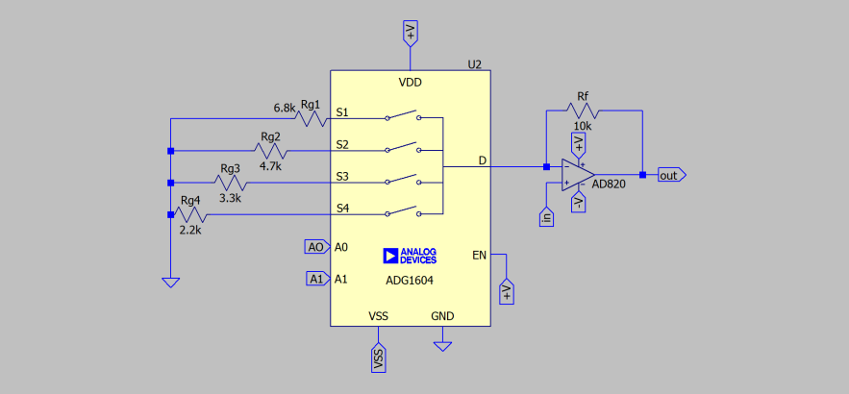
[picture p46: figure]
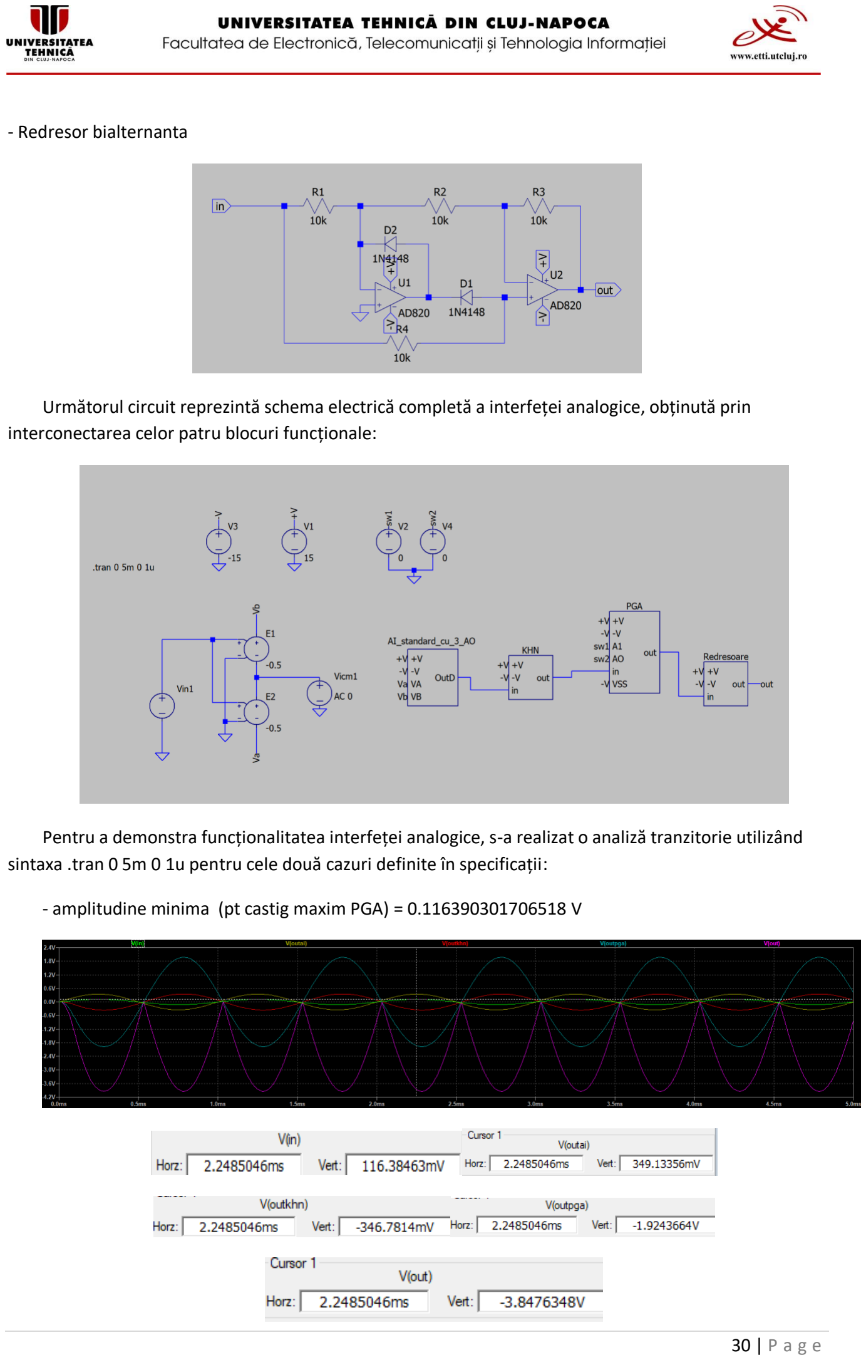
[picture p47: page 30]

- Redresor bialternanta

Următorul circuit reprezintă schema electrică completă a interfeței analogice, obținută prin interconectarea celor patru blocuri funcționale:

Pentru a demonstra funcționalitatea interfeței analogice, s-a realizat o analiză tranzitorie utilizând sintaxa .tran 0 5m 0 1u pentru cele două cazuri definite în specificații:

- amplitudine minima (pt castig maxim PGA) = 0.116390301706518 V

Simularea confirmă funcționarea liniară a lanțului de semnal pentru intrarea de 116.38 mV. Urmărind propagarea prin cele patru etaje, câștigul teoretic se validează astfel:

Atotal = 3 (AI) ∗ 1(Filtru) ∗ 5.55(PGA) ∗ 2(Redresor) = 33.3

Vout = 0.116 ∗ 33.3 => Vout = 3.86 V

-amplitudine maxima (pt castig minim PGA) = 0.232229182822873 V

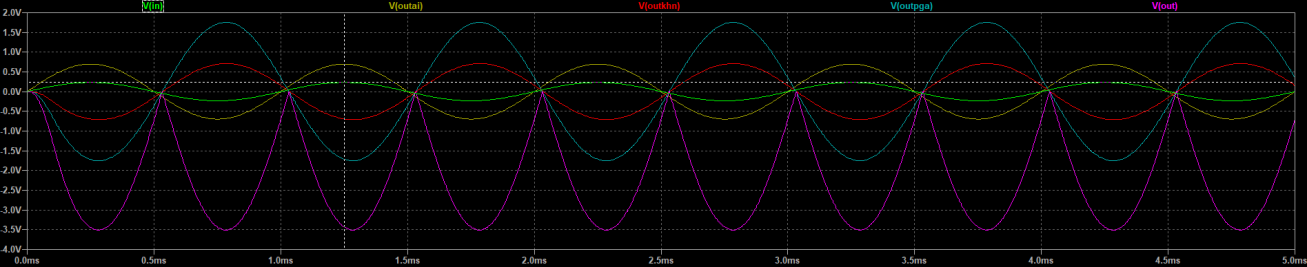
[picture p48: figure]

Simularea confirmă funcționarea liniară a lanțului de semnal pentru intrarea de 232.22 mV. Urmărind propagarea prin cele patru etaje, câștigul teoretic se validează astfel:

Atotal = 3 (AI) ∗ 1(Filtru) ∗ 2.47(PGA) ∗ 2(Redresor) = 14.82

Vout = 0.232 ∗ 14.82 => Vout = 3.43 V

## 5. Concluzii

Pentru validarea proiectului, s-a realizat o comparație între valorile calculate teoretic , cele obținute în urma simulării LTspice și cele măsurate in Scopy. Analiza este structurată pe fiecare bloc funcțional al interfeței analogice.

### 5.1. AI standard cu 3 AO

Câștigul AV | Eroare %
Valoare Teoretică | 3 | -
Valoare Simulată | 3 | 0%
Valoare Măsurată | 3.0095 | 0.3%

Cea mai probabilă cauză a erorii este data de toleranțele rezistențelor .

Banda la -3dB | Eroare %
Valoare Teoretică | 805 kHz | -
Valoare Simulată | 802.16 kHz | 0.35%
Valoare Măsurată | 1.52 MHz | 88.8%

Analiza valorii măsurate (1.52 MHz vs. 805 kHz): această diferență nu este o eroare de măsurare, ci o consecință directă a utilizării circuitului integrat OP482 în implementare

SlewRate | Eroare %
Valoare Teoretică | 3 V/μs | -
Valoare Simulată | 2.7 V/μs | 10%
Valoare Măsurată | 10.35 V/μs | 245%

Analiza valorii măsurate (10.35 V/μs vs 3 V/μs): diferența masivă provine, din nou, dinutilizarea circuitului integrat OP482 pentru implementarea . Valoarea lui OP482 este 9 V/μs, diferenta dintre valoare măsurată si teoretica este de 13.6%.

| Valoare Teoretică | Valoare Simulată | Eroare %
CMRR | 95.5 dB | 96.16 | 0.69%
PSRR | 95.5 dB | 109.81 | 14.98%

### 5.2. Low pass 3 AO V-V KHN

Câștigul AV | Eroare %
Valoare Teoretică | 1 | -
Valoare Simulată | -93.5 μdB | 0%
Valoare Măsurată | 0.10 dB | 1.16%
Banda la -3dB | Eroare %
Valoare Teoretică | 7 kHz | -
Valoare Simulată | 6.23 kHZ | 11%
Valoare Măsurată | 6.79 kHz | 3%

Eroarea este cauzată de toleranța rezistențelor si condensatoarelor si utilizate și de aproximația acestora la valorile standard disponibile.

### 5.3. RG parallel neinversor

Câștigul AV | SW1 ON | Eroare % SW1 | SW2 ON | Eroare % SW2
Valoare Teoretică | 7.9 dB | - | 9.9 dB | -
Valoare Simulată | 7.84 dB | 0.85% | 9.89 dB | 0.27%
Valoare Măsurată | 7.83 dB | 0.89% | 9.87 dB | 0.30%
Câștigul AV | SW3 ON | Eroare % SW3 | SW4 ON | Eroare % SW4
Valoare Teoretică | 12.1 dB | - | 14.9 dB | -
Valoare Simulată | 12.09 dB | 0.52% | 14.84 dB | 0.57%
Valoare Măsurată | 12.03 dB | 0.58% | 14.81 dB | 0.60%
Banda la -3dB | SW1 ON | Eroare % SW1 | SW2 ON | Eroare % SW2
Valoare Teoretică | 729 kHz | - | 575 kHz | -
Valoare Simulată | 767.4 kHz | 5.27% | 609.1 kHz | 5.93%
Valoare Măsurată | 745.8 kHz | 2.30% | 617.46 kHz | 7.38%
Banda la -3dB | SW3 ON | Eroare % SW3 | SW4 ON | Eroare % SW4
Valoare Teoretică | 447 kHz | - | 324 kHz | -
Valoare Simulată | 473.4 kHz | 5.90% | 336 kHz | 3.70%
Valoare Măsurată | 500 kHz | 11.86% | 378.29 kHz | 16.75%

Eroarea este cauzată de toleranța rezistențelor utilizate și de aproximația acestora la valorile standard disponibile. Realizarea circuitului pe breadboard introduce rezistențe de contact suplimentare și capacități parazite între trasee.

### 5.4. Redresoare bialternanta

Câștigul AV | Eroare %
Valoare Teoretică | 2 | -
Valoare Simulată | 1.998 | 0.1%
Valoare Măsurată | 1.97 | 1.5%

Eroarea este cauzată de toleranța rezistențelor care stabilesc câștigul etajului sumator/inversor.
