Tarnovean/Analog-Signal-Conditioning-Interface/Simulations/Blocks/AI_standard_3AO.asc

E1: e; -0.5
E2: e; -0.5
E3: e; -0.5
E4: e; -0.5
E5: e; -0.5
E6: e; -0.5
R1: res; 10k; tol=1 pwr=0.1
R2: res; 10k; tol=1 pwr=0.1
R3: res; 10k; tol=1 pwr=0.1
R4: res; 10k; tol=1 pwr=0.1
R5: res; 10K; tol=1 pwr=0.1
R6: res; 10K; tol=1 pwr=0.1
R7: res; 10k; tol=1 pwr=0.1
R8: res; 10k; tol=1 pwr=0.1
R9: res; 10k; tol=1 pwr=0.1
R10: res; 10K; tol=1 pwr=0.1
R11: res; 10K; tol=1 pwr=0.1
R12: res; 10k; tol=1 pwr=0.1
R13: res; 10k; tol=1 pwr=0.1
R15: res; 10K; tol=1 pwr=0.1
R16: res; 10k; tol=1 pwr=0.1
R17: res; 10k; tol=1 pwr=0.1
R22: res; 10k; tol=1 pwr=0.1
R44: res; 10k; tol=1 pwr=0.1
RG1: res; 10k; tol=1 pwr=0.1
RG2: res; 10k; tol=1 pwr=0.1
RG: res; 10k; tol=1 pwr=0.1
U1: AD820
U2: AD820
U3: AD820
U4: AD820
U5: AD820
U6: AD820
U7: AD820
U8: AD820
U9: UniversalOpAmp2
U10: AD820
V1: voltage; 15
V2: voltage; 15; AC 1
V3: voltage; -15
Vicm1: voltage; ""; AC 0
Vicm2: voltage; ""; AC 1
Vicm3: voltage; ""; AC 0
Vin1: voltage; ""; AC 1
Vin2: voltage; ""; AC 0
Vin3: voltage; ""; AC 0
Named nets: 0, +V, -V, OutD, OutCM, OutPS, +V_PS
LT6018 - Ultralow Disortion, Ultralow Noise Precision Op Amp
LT1678 - Low Noise RR Precision Op Amp
Low Noise, High CMRR Instrumentation Amplifier
Input: +/- 15 V
.ac dec 100 .01 10Meg
.meas AC AD FIND V(outd) AT 1
Measure low-frequency gain (and phase): .meas AC Gain_LowFrequency FIND <Function> AT <Frequency>
.meas AC ACM FIND V(outCM) AT 1
.meas AC BW FIND V(outd) WHEN mag(V(outd))=AD/sqrt(2) FALL=last
.meas AC CMRR FIND (V(outd)/V(outCM)) AT 1
.meas AC PSRR FIND (V(outd)/V(outPS)) AT 1
.meas AC APS FIND V(outPS) AT 1
