Tarnovean/Analog-Signal-Conditioning-Interface/Simulations/Blocks/Low_pass_KHN.asc

C1: cap; 10n
C2: cap; 4.7n
R1: res; 4.7k
R2: res; 4.7k
R3: res; 4.7k
R4: res; 4.7k
R5: res; 4.7k
R6: res; 4.7k
R7: res; 4.7k
U1: AD820
U2: AD820
U3: AD820
V1: voltage; 0; AC 1
V2: voltage; 15
V3: voltage; -15
Named nets: 0, +V, -V, out
.op
.ac dec 100 .01 10k
.tran 0 5m 0 1u
