Tarnovean/Analog-Signal-Conditioning-Interface/Simulations/Blocks/PGA_RG_paralel.asc

R1: res; 6.8k
R2: res; 4.7k
R3: res; 3.3k
R4: res; 2.2k
Rf: res; 10k
U1: AD820
U2: ADG1604
V1: voltage; 0; AC 1
V2: voltage; 15
V3: voltage; -15
V4: voltage; 5
V5: voltage; 5
V9: voltage; 5
V10: voltage; 0
Named nets: out, +V, -V, 0
.op
.ac dec 100 .01 10Meg
