Tarnovean/Analog-Signal-Conditioning-Interface/Simulations/Blocks/PGA_RG_paralel_simbol.asc

AD820: UniversalOpAmp2
Rf: res; 10k
Rg1: res; 6.8k
Rg2: res; 4.7k
Rg3: res; 3.3k
Rg4: res; 2.2k
U2: ADG1604
Named nets: out, +V, -V, AO, A1, VSS, 0, in
