Tarnovean/Analog-Signal-Conditioning-Interface/Simulations/Blocks/Redresor_bialternanta.asc

D1: diode; 1N4148
D2: diode; 1N4148
R1: res; 10k
R2: res; 10k
R3: res; 10k
R4: res; 10k
U1: AD820
U2: AD820
V2: voltage; 15
V3: voltage; -15
Vin: voltage; SINE(0 5 1k)
Named nets: 0, out, +V, -V, in, AO1
.op
.dc Vin -15 15 0.1
.tran 0 5m 0 1u
