Tarnovean/Analog-Signal-Conditioning-Interface/Simulations/Blocks/Redresor_bialternanta_simbol.asc

D1: diode; 1N4148
D2: diode; 1N4148
R1: res; 10k
R2: res; 10k
R3: res; 10k
R4: res; 10k
U1: AD820
U2: AD820
Named nets: out, 0, +V, -V, in
